yunchuanli003/stm32-3s-battery-monitor/THIRD-PARTY-NOTICES.md

# 第三方组件与商标声明

本仓库包含以下第三方组件，版权归各自所有者，遵循各自许可证。本仓库**未修改**这些文件，仅按原样随工程分发。

---

## 1. STM32F1 HAL Driver

| 项 | 内容 |
|---|---|
| 路径 | `02_固件代码/STM32F103C8T6/LYC1/Drivers/STM32F1xx_HAL_Driver/` |
| 版权 | Copyright (c) STMicroelectronics |
| 许可证 | BSD-3-Clause |
| 许可证全文 | 见同目录 `LICENSE.txt` |
| 许可来源 | <https://opensource.org/licenses/BSD-3-Clause> |

## 2. ARM CMSIS Core

| 项 | 内容 |
|---|---|
| 路径 | `02_固件代码/STM32F103C8T6/LYC1/Drivers/CMSIS/` |
| 版权 | Copyright (c) Arm Limited |
| 许可证 | **Apache License 2.0** |
| 许可证全文 | 见同目录 `LICENSE.txt` |
| 许可来源 | <https://www.apache.org/licenses/LICENSE-2.0> |

## 3. STM32F1 Device 支持包

| 项 | 内容 |
|---|---|
| 路径 | `02_固件代码/STM32F103C8T6/LYC1/Drivers/CMSIS/Device/ST/STM32F1xx/` |
| 版权 | Copyright (c) STMicroelectronics |
| 许可证 | **Apache License 2.0** |
| 许可证全文 | 见同目录 `LICENSE.txt` |
| 许可来源 | <https://www.apache.org/licenses/LICENSE-2.0> |

## 4. 启动文件

| 项 | 内容 |
|---|---|
| 路径 | `02_固件代码/STM32F103C8T6/LYC1/MDK-ARM/startup_stm32f103xb.s` |
| 版权 | Copyright (c) 2017-2021 STMicroelectronics |
| 许可证 | BSD-3-Clause |

---

## 说明

`Drivers/` 与 `MDK-ARM/startup_stm32f103xb.s` 由 STM32CubeMX 依 STM32CubeF1 软件包生成，许可证文件随组件一同保留，未做删改。各组件的版权头均保留在源文件顶部。

各许可证对再分发的要求（保留版权声明、随附许可证副本）均已满足。若你需要基于本项目二次分发，请一并保留 `Drivers/` 目录下的三个 `LICENSE.txt`。

---

## 商标声明

- **STM32**、**STM32F103C8T6** 为 STMicroelectronics International N.V. 的商标或注册商标。
- **Arm**、**Cortex**、**CMSIS** 为 Arm Limited 的商标或注册商标。
- **Keil**、**MDK-ARM** 为 Arm Limited 的商标或注册商标。
- **野火**、**野火小智** 为深圳市野火电子科技有限公司的商标。
- **江科大** 指 B 站 UP 主「江协科技」的 STM32 教学套件，与本项目无隶属关系。
- **Mornsun**、**金升阳** 为广州金升阳科技有限公司的商标。
- **Littelfuse** 为 Littelfuse, Inc. 的商标。
- **嘉立创**、**立创EDA**、**立创商城** 为深圳嘉立创科技集团股份有限公司的商标。

上述名称仅用于说明本项目所用元件、工具与参考对象，**不表示任何官方认证、合作、赞助或背书关系**。本项目为个人学习项目，与上述公司无任何隶属关系。

---

**最后更新**：2026-10-25
