yunchuanli003/stm32-3s-battery-monitor/03_硬件设计/采购记录_20261024.md

# 采购记录（2026-10-24 实际下单）

> 依据：`20261023_采购清单_v2.0.md`（22 料号 / 39 元件）+ 立创购物车实际导出（21 项）
> 用途：焊接时按位号找料，不用翻聊天记录；同时记录哪些料进了备件库
> 状态：立创已下单、淘宝已选定、PCB 已付款

---

## 〇、实际支出

| 单 | 平台 | 内容 | 金额 | 状态 |
|---|---|---|---|---|
| 第 1 单 | 立创商城 | 21 项，611 个元件 | 商品 ¥141.04 → **实付 ¥121.04** | 已下单 |
| 第 2 单 | 淘宝 | NTC 探头 + 尼龙柱 + 螺丝 | 约 ¥20 | 已选定 |
| 第 3 单 | 嘉立创 | 100×80 空板 5 片 | **¥33** | 已付款，预计 10-26/27 到 |
| **合计** | | | **约 ¥174** | |

立创实付拆解：`142.87（原价总额）− 1.83（商品折扣）+ 9（运费）− 20（优惠券）− 9（运费券）= 121.04`

---

## 一、立创商城实购明细（按位号排序）

「板用」= 这块板子实际要焊几个；「余」= 进备件库的数量。

| # | 位号 | 器件 | 规格 | 封装 | 板用 | 买入 | 余 | 料号 | 单价 |
|---|---|---|---|---|---|---|---|---|---|
| 1 | **U1 / U2** | 核心板座 | 2.54 mm 1×20P **排母** | 插件 | 2 | 5 | 3 | `C53207428` | ¥1.2294 |
| 2 | **U3** | LDO（WiFi 专用） | AMS1117-3.3，3.3V / 1A | SOT-223 | 1 | 5 | 4 | `C6186` | ¥1.2509 |
| 3 | **M1** | TB6612 模块座 | 2.54 mm 2×8P **双排母** | 插件 | 1 | 9 | 8 | `C54973830` | ¥1.5674 |
| 4 | **M2** | 5V 降压模块 | K7805-1000R3，8–36V 入 / 5V 1A 出 | SIP 11.5×9 | 1 | 2 | 1 | `C111280` | ¥15.49 |
| 5 | **F1** | 自恢复保险丝 | 1.5 A / 24 V | 1812 | 1 | 5 | 4 | `C78695` | ¥1.2075 |
| 6 | **D1** | 肖特基（防反接） | SS34，40V / 3A | SMA(DO-214AC) | 1 | 20 | 19 | `C2837271` | ¥0.1543 |
| 7 | **D2** | 双向 TVS | SMBJ15CA，Vrwm 15V | SMB(DO-214AA) | 1 | 5 | 4 | `C78809` | ¥0.9932 |
| 8 | **C1 / C2** | 电解电容 | 100 µF / 25 V | 插件 D6.3×L11 | 2 | 50 | 48 | `C49304911` | ¥0.1189 |
| 9 | **C3** | 陶瓷电容 | 22 µF / 25 V | 0805 | 1 | 20 | 19 | `C45783` | ¥1.1682 |
| 10 | **C4~C11、C13~C15** | 陶瓷电容 | 100 nF / 50 V X7R | 0603 | 11 | 50 | 39 | `C14663` | ¥0.0511 |
| 11 | **C12** | 陶瓷电容 | 10 µF / 25 V | 0805 | 1 | 20 | 19 | `C15850` | ¥0.2595 |
| 12 | **R1** | 电阻（分压上臂） | 51 kΩ ±1% | 0805 | 1 | 100 | 99 | `C17737` | ¥0.0407 |
| 13 | **R2 / R3 / R4** | 电阻 | 10 kΩ ±1% | 0805 | 3 | 100 | 97 | `C17414` | ¥0.0202 |
| 14 | **R5 / R6** | 电阻（LED / 蜂鸣器基极） | 1 kΩ | 0603 | 2 | 100 | 98 | `C21190` | ¥0.0101 |
| 15 | **Q1** | NPN 三极管 | S8050，Ic 500mA | SOT-23 | 1 | 50 | 49 | `C364312` | ¥0.0784 |
| 16 | **BUZ1** | 有源蜂鸣器 | Φ12×9.8，5V，2.4kHz，85dB | 插件 D=12 | 1 | 5 | 4 | `C96093` | ¥1.1812 |
| 17 | **SW1** | 轻触按键 | 6×6×5，四脚 | 插件-4P | 1 | 20 | 19 | `C18078025` | ¥0.1191 |
| 18 | **J1 / J2 / J7** | 接线端子 | KF301-2P，5.08 mm | 插件 P=5.08 | 3 | 5 | 2 | `C8465` | ¥0.7642 |
| 19 | **J3** | OLED 接口 | 2.54 mm 1×4P **排母** | 插件 | 1 | 10 | 9 | `C541851` | ¥0.4019 |
| 20 | **J5** | 串口 | 2.54 mm 1×3P 排针 | 插件 | 1 | 20 | 19 | `C2932698` | ¥0.1347 |
| 21 | **J6** | WiFi 接口 | 2.54 mm 1×6P 排针 | 插件 | 1 | 10 | 9 | `C37208` | ¥0.2547 |
| — | **LED1** | 发光二极管 | Φ3 mm 红发红 | 插件 | 1 | **未买** | — | 见下 §1.2 | — |

**校验**：板用合计 = **38**（原 BOM 39 − LED1）。买入合计 **611 个**。

---

## 1.1 料号替换对照（原编号已失效，全部换成现货）

首批 8 个料号在立创搜不到（无货 / 下架），已按**型号**重新查证并换成下列替代件，参数已逐项核对：

| 用途 | 原编号（失效） | 实买编号 | 品牌 / 差异 |
|---|---|---|---|
| 1×20P 排母 | `C50984` 无货 | **`C53207428`** | BXCONN PM-2.54-1×20-8.5-ZZ，8.5mm 高 |
| AMS1117-3.3 | `C5346136` 找不到 | **`C6186`** | AMS 原厂，SOT-223 |
| 2×8P 双排母 | `C42420228` 找不到 | **`C54973830`** | LAILAN，**直插**（首次误买 SMD 立贴，已纠正） |
| SS34 | `C9900023345` 找不到 | **`C2837271`** | JSMSEMI，SMA 40V/3A |
| SMBJ15CA | `C330064` 无货 | **`C78809`** | Littelfuse，SMB 双向 |
| S8050 | `C2931719` 无货 | **`C364312`** | MDD，SOT-23 NPN |
| KF301-2P | `C9900016950` 找不到 | **`C8465`** | WJ500V-5.08-2P |
| 1×4P 排母 | `C5138830` 无货 | **`C541851`** | XFCN，插件 |
| **蜂鸣器** | `C17701079` **需订货** | **`C96093`** | 华能 TMB12A05，Φ12×9.8，5V **有源** 2.4kHz |
| **LED1** | `C9900011189` | **未买** | 套件内 LED 灯珠可用（Φ3/Φ5 均可焊），省这笔 |

### 1.2 LED1 特殊情况

没在立创买，用套件里的裸灯珠。两套教学包配的都是面包板实验件，**大概率是 Φ5**（Φ5 引脚粗，插面包板接触更稳）。拆包后拿尺子量一下灯体直径即可确认。

**Φ3 和 Φ5 都能焊，不存在「装不进去」**（此前记录有误，2026-10-24 更正）：

| 项 | Φ3 LED | Φ5 LED | 板上 `LED-3MM` |
|---|---|---|---|
| 引脚直径 | ~0.45 mm | ~0.6 mm | 孔径 **0.9 mm**，都过得去 |
| 引脚间距 | 2.54 mm | 2.54 mm | 焊盘间距 **2.54 mm**，完全一致 |
| 本体直径 | 3 mm | 5 mm | 丝印轮廓 3 mm，Φ5 会盖住，不影响电气 |

**Φ5 的焊接手法**：Φ5 灯体底部有 Φ5.9 的凸缘，插到底会把两个焊盘完全压住、烙铁进不去。所以插进去先留 2 mm 悬空焊接，焊完两个脚再推到底。

顺序不变：**贴片电阻电容先焊完，LED 最后焊**（先低后高）。

量出来是 5 mm 也不用补单——丝印被盖住不影响任何功能。要好看再单买 `C9900011189`（¥0.01/个，但要凑起送量或运费）。

### 1.3 蜂鸣器极性（装的时候最容易反）

- 板上封装：`BUZ-TH_BD12.0-P7.60-D0.6`（Φ12.0 / 脚距 7.6mm / 脚径 0.6）
- 丝印「**+**」在**板子左侧**（x=10.20），对应 1 脚 `+5V`
- **正极脚（长脚）插左边**，2 脚接 Q1 集电极

---

## 二、淘宝单（已选定）

| 物品 | 规格 | 实选 | 数量 | 金额 |
|---|---|---|---|---|
| NTC 温度探头 | **10 kΩ B=3950**，两线，线长 500mm，**线尾 3mm 上锡** | 博创电器，**水滴头** | 2 | ¥2~5 |
| 尼龙柱 | **双通**内螺纹、M3×10、平头六角 | 佰瑞特，M3×10 白色 | 100 | ¥6.16 |
| 螺丝 | M3×6，尼龙，十字盘头 | 固方基，M3×6 黑色 | 40 | ¥2.5 |

### 2.1 三个坑，已逐一避开

1. **NTC 必须是裸两线探头**，不要「热敏电阻传感器模块」（那是 LM393 比较器板，4 脚，AO 低阻输出会和板上 R3 上拉对打）
2. **NTC 的 B 值必须 3950**。买 3435 的话 25℃ 附近还准，往后每 10℃ 偏 1~2℃，整个量程都歪——固件里写死 `NTC_B = 3950.0f`
3. **尼龙柱必须「双通」**（两端都是内螺纹）。第一次选成「单通 M3×10+6」（下端是外螺纹），**裸板没有底板就固定不了**。双通柱底部平整，才能当脚立在桌面上

### 2.2 装配尺寸验算（已核对）

| 项 | 数值 | 结论 |
|---|---|---|
| 六角对边 5.5mm → 外接圆半径 | 3.17mm | 孔心距板边 5mm，余 **1.83mm**，不超板边 |
| 柱长 10mm vs 板底焊点高度 | 10 vs 2~3mm | 余 **7mm**，够 |
| M3×6 螺杆穿板后余量 | 6 − 1.6 = 4.4mm | 咬合 4.4mm，够力（标准 ≥0.75mm） |
| 螺丝头 φ5.6 vs 孔心距板边 | 5 − 2.8 = 2.2mm | 不超板边，不压走线 |

---

## 三、PCB（已付款）

| 项 | 值 |
|---|---|
| 板框 | 100 × 80 mm，2 层，1.6 mm，1 oz |
| 表面处理 | 有铅喷锡（**不是** OSP —— OSP 不耐反复加热，手工返修会掉）。样机不进入流通领域，商品化时须改无铅以满足 RoHS |
| 确认生产稿 | **需要**（自绘板唯一能在开产前拦 Gerber 错误的环节） |
| 数量 / 费用 | 5 片 / **¥33**（板材 20 + 确认生产稿 3 + 品质赔付 10） |
| 安装孔 | 四角 M3 **非金属化**，孔心 (5,5)/(95,5)/(5,75)/(95,75) |
| 预计到货 | 10-25 晚发货，10-26/27 到 |

⚠️ **生产稿通知到了先截图核对，不要自己点确认。** 重点看：板框 100×80、过孔盖油、丝印有没有压焊盘。

---

## 四、板子到货后第一件事（验收四步）

1. **量尺寸**：游标卡尺量四角孔径（应 3.2mm）、板框（应 100×80）、核心板两排针间距（应 22.86mm）
2. **对极性丝印**（四类，装反都要返工）：
   - C1 / C2 电解：**「+」在左侧**
   - D1 SS34：**阴极带在右侧**
   - LED1：**「+」在右侧**
   - BUZ1 蜂鸣器：**「+」在左侧**
3. **看 J3 插装方向**：1 脚位置与丝印方焊盘是否一致
4. **3D 预览目视**：拿实物对照 `pcb_polarity_zoom.png`

---

## 五、焊接耗材（如缺则补）

| 物品 | 用途 | 是否必备 |
|---|---|---|
| 焊锡丝 0.6–0.8mm **含铅** | 手焊 0603/0805，熔点低好操作 | 必备 |
| 助焊剂（松香或免洗膏） | 焊 0603 时让锡自己爬到位 | 必备 |
| 吸锡带 | 连锡了补救 | 必备 |
| 尖头镊子 | 夹 0603 元件 | 必备 |
| 无水酒精 + 棉签 | 洗助焊剂残留 | 建议 |
| 放大镜 / 手机微距 | 检查虚焊 | 建议 |

---

## 六、到货后先别焊：分装

0603 的电阻电容肉眼分不出 1k 和 10k。**到货第一件事是按位号分装**，20 分钟换焊接时省 2 小时：

| 袋子 | 装什么 | 数量 |
|---|---|---|
| R1 | 51 kΩ 0805 | 取 2 个 |
| R2/R3/R4 | 10 kΩ 0805 | 取 6 个 |
| R5/R6 | 1 kΩ 0603 | 取 4 个 |
| C1/C2 | 100 µF 电解 | 取 3 个 |
| C3 | 22 µF 0805 | 取 2 个 |
| C12 | 10 µF 0805 | 取 2 个 |
| C4~C15 | 100 nF 0603 | 取 20 个 |
| 其余 | 排母、排针、端子、三极管、二极管、按键、蜂鸣器 | 按表取 |

---

**经验教训**

1. **立创购物车的数量受「最小起送量」约束**，不是所有料都能拆零买。22 µF 20 个 ¥23.36、100 µF 50 个、4 个电阻各 100 个——全是整包量。下次列 BOM 直接按「整包量」预估总价，别按实际用量报数，否则预算对不上（这次预估 ¥70，实际 ¥141）。
2. **C 编号会随品牌批次失效**，长期稳定的是「型号 + 关键参数」。查料按型号搜，别死磕编号。
3. **插件 vs 贴片看封装栏**：「插件 / 直插 / DIP」要打孔，「SMD / 贴片 / 立贴」贴表面。板上预留的是直插孔，就不能买 SMD。
4. **排母要分清行距**：2.54 排母有「行距 2.54」和「行距 2.0」两种，TB6612 模块是标准 2.54 双排。
