yunchuanli003/stm32-3s-battery-monitor/01_文档资料/02_问题跟踪/20260604_串口打印延迟问题修复计划_v1.0.md

# 串口打印延迟问题修复计划

## 问题分析

现象：
1. KEY2短按停止系统后，串口不打印"系统已经停止"信息
2. 按下RESET复位后，"系统已经停止"和"系统已经开启"的信息一起打印出来

## 根本原因

**串口发送缓冲区问题**：虽然 `fputc` 使用了 `HAL_UART_Transmit` 阻塞发送，但在系统状态切换时，可能存在以下问题：

1. **按键释放时触发**：短按逻辑在按键释放时才触发停止，此时可能系统状态有变化
2. **缺少发送完成确认**：printf 后没有等待串口真正发送完成
3. **逻辑时序问题**：可能某些操作影响了串口发送

## 修复方案

### 方案：先打印信息，等待发送完成，再改变系统状态

1. 调整按键逻辑，确保 printf 后添加短暂延时
2. 使用 `HAL_UART_GetState()` 确认串口发送完成
3. 优化蜂鸣器反馈的时机

## 具体修改步骤

### 步骤1：优化按键扫描函数
**文件：** `02_固件代码/STM32F103C8T6/LYC1/Core/Src/main.c`
- 短按停止：printf 后增加延时，确保串口发送完成
- 长按开启：同样确保打印完成

### 步骤2：添加发送完成等待
**文件：** `02_固件代码/STM32F103C8T6/LYC1/Core/Src/main.c`
- 使用 `while(HAL_UART_GetState(&huart1) != HAL_UART_STATE_READY)` 等待发送完成
- 或添加足够的延时（约20-50ms）

## 代码修改清单

| 文件 | 修改内容 |
|---|---|
| `Core/Src/main.c` | 优化按键扫描中的串口打印逻辑，确保信息发送完成 |

## 验证方法

1. 烧录修改后的代码
2. 短按KEY2，串口应立即显示"系统已经停止"
3. 长按KEY2，串口应立即显示"系统已经开启"
4. 不需要按复位就能看到打印信息
