yunchuanli003/stm32-3s-battery-monitor/01_文档资料/02_问题跟踪/20260604_按键无响应问题修复计划_v1.0.md

# 按键无响应问题修复计划

## 问题分析

现象：
- RESET按键正常（系统复位）
- KEY1和KEY2两个按键都没有效果

## 根本原因排查

### 可能原因1：PC13引脚特殊性
STM32F103C8T6的PC13引脚有以下特性：
- PC13/PC14/PC15通常用于RTC（实时时钟）功能
- 作为GPIO输出时，驱动能力有限
- 作为输入时可能需要特殊处理

### 可能原因2：按键扫描频率问题
- 系统运行时主循环延时900ms
- 按键扫描只在循环开始时执行一次
- 可能错过按键按下的时机

### 可能原因3：硬件连接问题
- 野火核心板的按键实际接法可能与例程不一致
- 需要实际测试确认引脚电平

## 修复方案

### 方案一：优化按键扫描（推荐）
1. 增加按键扫描频率，每50ms扫描一次
2. 将按键扫描与主循环延时分离
3. 使用独立的时基或缩短延时

### 方案二：添加按键测试代码
1. 在按键按下时添加蜂鸣器或LED反馈
2. 方便调试确认按键是否被识别

### 方案三：确认PC13引脚配置
1. 检查PC13是否有其他功能占用
2. 确认上下拉配置是否正确

## 具体修改步骤

### 步骤1：优化主循环结构
**文件：** `02_固件代码/STM32F103C8T6/LYC1/Core/Src/main.c`
- 缩短主循环延时到100ms
- 使用计数器控制ADC采样频率（1秒一次）
- 确保按键每100ms扫描一次

### 步骤2：添加按键调试反馈
**文件：** `02_固件代码/STM32F103C8T6/LYC1/Core/Src/main.c`
- 按键按下时，蜂鸣器"滴"一声作为反馈
- 方便确认按键是否被识别

### 步骤3：修正PC13引脚配置（如果需要）
**文件：** `02_固件代码/STM32F103C8T6/LYC1/Core/Src/gpio.c`
- 确认PC13的上下拉配置是否正确
- 如果有问题，改为上拉或浮空

## 代码修改清单

| 文件 | 修改内容 |
|---|---|
| `Core/Src/main.c` | 优化主循环，增加按键扫描频率，添加按键反馈 |
| `Core/Src/gpio.c` | 确认并修正按键引脚配置 |

## 验证方法

1. 烧录修改后的代码
2. 按下KEY1，蜂鸣器应滴一声，串口显示"系统已经开启"
3. 按下KEY2，蜂鸣器应滴一声，串口显示"系统已经停止"
4. 如果按键有响应但功能不对，再调整具体逻辑
