yunchuanli003/stm32-3s-battery-monitor/03_硬件设计/PCB设计/20261021_PCB打样设计输入_v1.0.md

# PCB 打样设计输入（第一版）

> 目标：把现有面包板方案转成一块可打样的 2 层板，功能与 v2.0 固件保持一致
> 工具：立创EDA（专业版）
> 状态：原理图已于 2026-10-22 完成 4 页；PCB 已于 2026-10-23 完成布局 + 布线 + 铺铜 + DRC，Gerber 已导出。第三、四节已按实际网表校准

---

## 〇、三个设计前提

| 前提 | 选择 | 理由 |
|---|---|---|
| MCU 形态 | **沿用现成核心板**，用两个 1×20P 排母（合计 40 脚）插装 | 核心板自带晶振、复位、USB、3.3V LDO，省掉最容易翻车的部分；第一次打样不值得冒这个险 |
| 电机驱动 | **TB6612 模块**，2×8 排母插装 | FNG 芯片是 SSOP-24，手工焊接成功率低；模块几块钱，坏了直接换 |
| 降压 | **K7805-1000R3 开关稳压模块**（金升阳 MORNSUN，C111280） | 8–36 V 入、5 V/1 A 出、效率 93%、SIP-3 直插、引脚与 LM78xx 兼容。**选它而不选淘宝 MP1584 迷你模块的原因**：有完整规格书、焊盘落在 2.54 网格上。淘宝 22×17 迷你模块的焊盘「端到端不在 0.1″ 网格」，物理上插不进任何排母，也插不进面包板 |

> 这套思路叫"模块化降风险"：把不可控的环节（焊接、开关电源布局）交给成熟模块，自己只画可控的部分（接口、采样、保护、指示）。
> 这套「模块化降风险」的取舍理由是可复述的：能讲清为什么第一版不集成，比画得花哨更显工程判断。

---

## 一、电源架构（最关键的一节）

```
3S 电池 9.0–12.6 V
   │
   ├─ 保险丝 1.5 A → 防反接 SS34 → ├─ Buck(K7805) → 5 V ─┬─ 核心板 5V 引脚（板载 LDO 再降 3.3 V）
   │                              │                      ├─ 蜂鸣器（有源 5 V）
   │                              │                      └─ U3 AMS1117-3.3 → +3V3_WIFI（WiFi 专用，见 11.2）
   │                              └─ TB6612 VM（12.6 V 直供）→ 130 电机
   └─ GND
```

**为什么不是 12.6 V 直接降到 3.3 V**

AMS1117 类是线性稳压，压差全变成热。12.6 V → 3.3 V、负载 70 mA，功耗 ≈ 0.65 W，SOT-223 封装结温会逼近 125 ℃ 触发过温保护，表现为输出电压跌落、MCU 反复复位。这类故障极难从软件侧定位。

**为什么走 5 V 再进核心板**

核心板板载 LDO 吃 5 V 只需降 1.7 V，功耗约 0.12 W，安全。这样整块板只做一级 Buck，架构最简单。

**必须加的元件**

| 位置 | 元件 | 作用 |
|---|---|---|
| 电池入口 | 自恢复保险丝 1.5 A（如 MF-MSMF150） | 短路保护 |
| 电池入口 | SS34 肖特基（SMA 封装） | 防反接；正常压降 0.5 V，12.6 → 12.1 V，可接受 |
| Buck 输入 | 100 µF/25 V 电解 + 0.1 µF 陶瓷 | 抑制电池线束电感引起的输入纹波 |
| Buck 输出 5 V | 22 µF + 0.1 µF | 输出储能与高频去耦 |
| TB6612 VM | 100 µF/25 V 电解 + 0.1 µF，**紧贴模块 VM 与 GND 引脚** | 电机换向瞬间的电流尖峰靠它吸收 |
| 电机端子 | 0.1 µF 跨接电机两端 + 双向 TVS（SMBJ15CA） | 换向反电动势泄放 |

---

## 二、模拟采样电路

### 2.1 电压采样

| 项 | 取值 |
|---|---|
| 上臂 R1 | 51 kΩ，1%，0805 |
| 下臂 R2 | 10 kΩ，1%，0805 |
| 分压比 | (51+10)/10 = **6.10** |
| 12.6 V 时分压点电压 | 2.07 V（ADC 满量程 3.3 V，余量充足） |
| 源阻抗 | 51k ∥ 10k ≈ **8.4 kΩ**（STM32F1 在 239.5 周期采样下允许约 50 kΩ，安全） |
| 滤波 | 分压点对地 **100 nF**（X7R，0603），走线尽量短，紧贴 PA4 |
| 分辨率 | 3.3 V / 4095 ≈ 0.806 mV，折算到电池端约 **4.9 mV** |

> 换 1% 电阻后，固件里的 `divider_k = 6.21f` 需要按实测重新标定一次（原值来自旧电阻的实际误差）。
> 标定方法沿用你原来的：万用表实测电池电压 → `新系数 = 旧系数 × 实测值 / 显示值`。

### 2.2 温度采样

| 项 | 取值 |
|---|---|
| NTC | 10 kΩ，B=3950，1%，**外接式防水探头，不焊在板上** |
| 接入方式 | 2P 螺钉端子 **J7**（KF301-2P，与 J1/J2 同款），探头引线拧入端子，探头主体贴电池壳体 |
| 上拉 | 10 kΩ，1%，接 3.3 V |
| 接法 | **NTC 在下臂**（NTC 到 GND，上拉电阻到 3.3 V） |
| 25 ℃ 时分压点 | 1.65 V |

**NTC 走 J7 端子外接，而不是直插焊在板上。** 三个理由：① NTC 必须贴到电池壳体上才测得到电芯温度，焊死在板子上只能测环境温度；② 裸 NTC 珠子没有机械强度，四根引线被反复弯折会断在根部；③ 端子让探头可更换——B 值不对、量程不合适直接换一根，不用动板子。

> 注意：江科大套件里那款「热敏电阻传感器模块（4 脚：VCC/GND/DO/AO）」**不能用**。它是 LM393 比较器模块，AO 是低阻运放输出，接到本板 J7 上会与 R3 上拉直接对打，而且它自带一路分压，等于两次分压、量程全乱。要买的是**裸 NTC 探头**（10 kΩ B3950，两根线，防水封装）。

**接法必须保持 NTC 在下臂**，这样温度升高 → NTC 阻值下降 → 分压点电压下降，与现有固件 `temperature = 25.0f + (1.65f - temp_volt) * 15.0f` 的方向一致，改板不用改代码。

**但这条公式建议重写。** 10 k/B3950 在 25 ℃ 附近灵敏度约 4 %/℃，换算成电压约 25~27 ℃/V，而当前用 15 ℃/V，斜率只有实际的一半左右。粗算下来：

| 实际温度 | 分压点电压 | 当前公式读数 | 偏差 |
|---|---|---|---|
| 25 ℃ | 1.65 V | 25.0 ℃ | 0 |
| 28 ℃ | 1.57 V | 26.2 ℃ | −1.8 ℃ |
| 32 ℃ | 1.48 V | 27.5 ℃ | −4.5 ℃ |
| 35 ℃ | 1.42 V | 28.4 ℃ | −6.6 ℃ |

温度越高偏差越大，而风扇的两个阈值（28 ℃、32 ℃）正落在这段区间。**打样顺手把温控改准，是这个项目最划算的一次改进**——硬件不用动，只换固件里的换算方式（查表或 Steinhart-Hart），误差能从数度降到 0.5 ℃ 内。

### 2.3 按键

10 kΩ 上拉到 3.3 V，并联 100 nF 做硬件消抖，再进 PC13。软件里的 10 次计数消抖可以保留，也可以减到 3 次。

---

## 三、器件清单

> 已按位号排序，与立创 EDA 网表逐项对应（共 39 个元件，不含安装孔）。LCSC 编号可直接导入商城 BOM。

| 位号 | 器件 | 规格 | 封装 | 数量 | LCSC |
|---|---|---|---|---|---|
| U1 / U2 | 核心板座 | 2.54 mm **1×20P 排母**（两块拼成 40 脚） | 直插 | 2 | C50984 |
| U3 | 独立 LDO（WiFi 专用） | AMS1117-3.3 | SOT-223 | 1 | C5346136 |
| M1 | TB6612 模块座 | 2.54 mm 2×8P 双排母，DS1023-02-2x8SF11 | 直插 | 1 | C42420228 |
| M2 | 5 V 降压模块（开关型） | K7805-1000R3，8–36 V 入 / 5 V 1 A 出，效率 93%，立式高 17.5 mm | SIP-3 直插 | 1 | C111280 |
| F1 | 自恢复保险丝 | 1.5 A / **24 V** | 1812 | 1 | C78695 |
| D1 | 肖特基（防反接） | SS34 | SMA | 1 | C9900023345 |
| D2 | 双向 TVS | SMBJ15CA | SMB | 1 | C330064 |
| C1 / C2 | 电解电容 | 100 µF / 25 V | 直插 φ6.3 | 2 | C49304911 |
| C3 | 陶瓷电容 | 22 µF / **25 V** | 0805 | 1 | C45783 |
| C4~C10 | 陶瓷电容（`+5V` 去耦） | 100 nF / 50 V X7R | 0603 | 7 | C14663 |
| C11 | 陶瓷电容（PA4 ADC 滤波） | 100 nF / 50 V | 0603 | 1 | C14663 |
| C12 | 陶瓷电容 | 10 µF / **25 V** | 0805 | 1 | C15850 |
| C13 | 陶瓷电容（`+3V3_WIFI` 去耦） | 100 nF / 50 V | 0603 | 1 | C14663 |
| C14 | 陶瓷电容（PA5 ADC 滤波） | 100 nF / 50 V | 0603 | 1 | C14663 |
| C15 | 陶瓷电容（PC13 按键消抖） | 100 nF / 50 V | 0603 | 1 | C14663 |
| R1 | 电阻（分压上臂） | 51 kΩ ±1% | 0805 | 1 | C17737 |
| R2 | 电阻（分压下臂） | 10 kΩ ±1% | 0805 | 1 | C17414 |
| R3 | 电阻（NTC 上拉） | 10 kΩ ±1% | 0805 | 1 | C17414 |
| R4 | 电阻（按键上拉） | 10 kΩ ±1% | 0805 | 1 | C17414 |
| R5 | 电阻（LED 限流） | 1 kΩ | 0603 | 1 | C21190 |
| R6 | 电阻（蜂鸣器基极） | 1 kΩ | 0603 | 1 | C21190 |
| Q1 | NPN 三极管 | S8050 | SOT-23 | 1 | C2931719 |
| BUZ1 | 有源蜂鸣器（内含驱动线路） | HYE1206-05ST，5 V，2.6 kHz，Φ12，脚距 7.6 | 直插 | 1 | C17701079 |
| LED1 | 发光二极管 | Φ3 mm 红 | 直插 | 1 | C9900011189 |
| SW1 | 轻触按键 | 6×6×5，四脚 | 直插 | 1 | C18078025 |
| J1 | 电池输入端子 | KF301-2P | 直插 | 1 | C9900016950 |
| J2 | 电机输出端子 | KF301-2P | 直插 | 1 | C9900016950 |
| J3 | OLED 接口 | 2.54 mm 1×4P **排母**（模块公针直插） | 直插 | 1 | C5138830 |
| J5 | 串口 | 2.54 mm 1×3P 排针 | 直插 | 1 | C2932698 |
| J6 | WiFi 模块 | 2.54 mm 1×6P 排针 | 直插 | 1 | C37208 |
| J7 | NTC 温度探头端子 | KF301-2P | 直插 | 1 | C9900016950 |
| H1~H4 | 安装孔 | M3，内径 3.2 mm，非金属化 | — | 4 | — |

**四处需要留意**：

1. **M1 已锁定 C42420228**（DS1023-02-2x8SF11）。原先用的通用件「2.54 2」对应料号 C9900000696 是库里的残件——元件属性看着齐全，但网表只导出 `DESIGNATOR / FOOTPRINT / PARTTYPE` 三行，`Supplier Part` 永远为空，怎么改属性都不生效。已换成完整的 DS1023 重画，16 个引脚网络逐个复核通过。
2. **U1/U2 是两个独立的 1×20P 排母**，不是一体式 2×20P。野火核心板是两条 20 脚单排针，买 2×20 一体座插不进去。
3. **NTC 不再作为板上元件（RN1 已删除）**，改为 J7 端子 + 外购防水探头。BOM 里因此没有 NTC，探头需在淘宝单独买（10 kΩ B3950 防水型，2 根为一份，留一根备用）。
4. **板上不再有 SWD 调试口（J4 已删除，2026-10-23）**。原 J4 是 1×4P 排针，接 `+3V3 / SWDIO / SWCLK / GND`，但 `SWDIO`、`SWCLK` 在网表里**各自只有 J4 自己的一个脚**——野火核心板的 40 针排母根本没有引出 PA13/PA14，这块板上插 DAP 进去也识别不到芯片。调试改走**核心板自带的调试排针**（板上有丝印，直连 PA13/PA14），烧录走核心板 Type-C。省下 4 个焊盘和一段容易在答辩时被追问的丝印。

---

## 四、网络连接表（画原理图的直接依据）

> 本表已于 **2026-10-22** 按立创 EDA 实际网表（Protel2）校准，引脚号以 `位号-脚号` 写死。

| 网络名 | 连接对象 |
|---|---|
| `VBAT` | J1-1、F1-1 |
| `VBAT_FUSE` | F1-2、D1-2（**阳极**）。保险丝之后、防反接之前，只有这一段 |
| `VBAT_F` | D1-1（**阴极**）、M2-1（K7805 **Vin**）、C1-1、C2-1、M1-1（TB6612 VM）、R1-1（分压上臂）。**全板主母线，都在防反接之后** |
| `+5V` | M2-3（K7805 **Vout**）、C3-1、U3-3（IN）、C4~C10、U1-19（5V 引脚）、BUZ1-1 |
| `+3V3` | U1-15 / U1-17、U2-1 / U2-20、M1-2（TB6612 VCC）、J3-2、R3-1、R4-1 |
| `GND` | J1-2、M2-2、C1-2、C2-2、C3-2、C4~C11 的 -2 脚、C12-2、C13-2、C14-2、C15-1、U3-1、R2-2、**J7-2**、M1-3 / M1-8 / M1-13~16、Q1-2、LED1-1、SW1-1 / SW1-2、U1-18 / U1-20、U2-2 / U2-19、J3-1、J5-1、J6-2、H1~H4 |
| `PA4` | R1-2、R2-1、C11-1、U1-10 |
| `PA5` | R3-2、**J7-1**、C14-1、U1-9 |
| `PB12` / `PB13` | M1-11（AIN1）/ M1-10（AIN2）（原 PA2/PA3，见引脚冲突核查） |
| `PA6` | M1-9（PWMA） |
| `PB14` | M1-12（STBY）（原 PA8） |
| `AO1` / `AO2` | M1-4 / M1-5 → J2-1 / J2-2；D2 跨接在这两端（双向 TVS） |
| `PB0` | U1-6、R6-1（→ Q1-B），Q1-C → BUZ1-2 |
| `PB1` | U1-5、R5-1 → LED1-2（阳极） |
| `PB6` / `PB7` | U2-15 / U2-16 → J3-3（SCL）/ J3-4（SDA） |
| `PA9` / `PA10` | U2-5 / U2-6 → J5-2（TX）/ J5-3（RX） |
| `PC13` | U1-16、R4-2、SW1-3 / SW1-4、C15-2 |
| `USART3_TX` | U1-4（PB10）→ J6-3（接模块 RX） |
| `USART3_RX` | U1-3（PB11）→ J6-4（接模块 TX） |
| `+3V3_WIFI` | U3-OUT、C12、C13、J6-1 |
| `WIFI_EN` | J6-5 → 模块使能。**板上不设上拉**：NodeMCU V3 底板自带 10 kΩ 上拉到 3.3 V + RST 按键，两处 10 kΩ 并联只会变成 5 kΩ，无收益。该网络仅 J6-5 一个引脚，DRC 的单引脚告警**属有意为之** |
| `WIFI_IO0` | J6-6 → 烧录模式选择。**板上不设上拉**：NodeMCU 底板自带 10 kΩ 上拉 + FLASH 按键，拉低进下载。该网络仅 J6-6 一个引脚，DRC 的单引脚告警**属有意为之** |

> ### ✅ D1 接法已修正（2026-10-22，方案 A）
>
> 原图纸把 D1 只串在 Buck 这一路：`VBAT_F` 挂在阳极侧，TB6612 VM 与 C1/C2 两颗 100 µF 电解直接承受反接电压，电解会鼓包爆裂。
>
> 现改为 **`F1-2` → D1 阳极，D1 阴极 → `VBAT_F` 主母线，Buck 也从母线取电**。全板（TB6612 VM、电解、分压、Buck）统一受 SS34 保护。
>
> 网表已复核：`VBAT_FUSE` = F1-2 + D1-2(A)；`VBAT_F` = D1-1(K) + M2-1 + C1-1 + C2-1 + M1-1 + R1-1；原 `VBAT_IN` 网络消失。DRC 无新增告警。
>
> 代价：电机端少一个肖特基压降（12.6 → 12.1 V，约 4%），SS34 在 1.5 A 下耗散约 0.75 W，选型需注意散热。

---

## 五、布局约束（先摆位，再拉线）

板子建议 **100 × 80 mm 以内**，四角 M3 安装孔。

| 区域 | 位置 | 放什么 |
|---|---|---|
| 电源区 | 左侧，靠近电池端子 | J1、F1、D1、C1、Buck 模块、C3 |
| 功率区 | 右下，靠近电机端子 | TB6612 模块、C2、J2、D2 |
| 模拟区 | 中部偏上 | R1、R2、R3、**J7**、C11 ×2 |
| 数字区 | 中部 | U1（核心板）、SW1、OLED、LED、蜂鸣器 |
| **扩展预留区** | 右上角，贴板边 | WiFi/BLE 模块排针位（J6）+ 天线净空带 |

四条硬约束：

1. **ADC 滤波电容紧贴 PA4 / PA5 引脚**，中间不串过孔，走线长度控制在 5 mm 内
2. **TB6612 的 100 µF 电解必须紧贴模块 VM 与 GND 引脚**，走线宽度 ≥ 1 mm
3. **电机大电流回路（VM → TB6612 → 电机 → GND）面积越小越好**，不要绕板子一圈
4. **右上角沿板边留 30 × 20 mm 空区**，且该区域正对的天线净空带内**不铺铜、不走线、不放器件**（详见第十一节）
5. **J7 靠板边放**（螺钉端子的进线口朝外），距板边 ≥ 2 mm 且 ≤ 6 mm，探头引线能直接出板不被器件挡住；不要放在核心板正下方，否则探头要先绕过整块板

接地策略：底层整块铺 GND 不切碎；功率地与信号地在电池端子处单点汇合，不要在两处相连形成环路。

---

## 六、布线要点

| 线类 | 宽度 | 说明 |
|---|---|---|
| 电机回路（VM、OUT1/OUT2、GND） | 2.0 mm 或铺铜 | 130 电机堵转峰值可达 1.5 A |
| 12 V 输入 | 1.0 mm | |
| 5 V | 0.8 mm | |
| 普通信号 | 0.25 mm | |
| ADC 走线 | 0.25 mm，两侧包地 | 远离 PWM 与电机走线 |

顺序建议：**电源 → 功率 → 模拟 → 信号**。先画电流最大的，再画最敏感的。

---

## 七、嘉立创打样参数

| 项 | 选择 | 实际落实情况（2026-10-23） |
|---|---|---|
| 层数 | 2 层 | ✅ 顶层信号 + 底层信号，双面 GND 铺铜 |
| 板材 / 厚度 | FR-4，1.6 mm | ✅ 1.6 mm（嘉立创唯一不加价档，0.8~1.6 常规板；2.0 mm 属非标要换压合模具） |
| 铜厚 | 1 oz（35 μm） | ✅ 1 oz（2 oz 蚀刻时间延长、产能下降，基础费加收约 30%） |
| 阻焊 / 丝印 | 绿色 / 白色 | ✅ 绿色（蓝/红/白每款加 50 元，绿色不加） |
| 表面处理 | 喷锡。**本样机按有铅下单**，仅因手工焊接熔点低、返修容易 | ✅ 喷锡（沉金加 100 元，无铅喷锡加 30 元） |
| 最小线宽/间距 | 6/6 mil | ✅ 信号线 **10 mil (0.254 mm)**，最小光圈 8 mil；间距规则未报任何违规 |
| 最小过孔 | 0.3 / 0.6 mm | ✅ **0.3 mm 孔 / 0.61 mm 盘**，焊环 0.155 mm（嘉立创双面板最小焊环 0.13 mm） |
| 尺寸 | ≤ 100 × 100 mm（5 片档位最划算） | ✅ **100 × 80 mm**，Gerber 实测板框 100.000 × 80.001 mm |
| 拼板 | 不需要，单片即可 | ✅ 单片 |
| 安装 | — | ✅ 4 个 M3 孔，孔径 3.2 mm / 外径 3.6 mm，**非金属化（NPTH）**，孔心距板边 5 mm |

> **环保合规说明**：本板为个人验证样机，不进入流通领域，故未按 RoHS 选无铅工艺。若该设计需要商品化或送第三方检测，应改用**无铅喷锡**（嘉立创加价约 ¥30 即可满足工艺要求），并按 **RoHS 2011/65/EU** 与 **GB/T 26572** 核对 BOM 中 22 个料号的有害物质声明，重点核查电解电容、蜂鸣器、LED 的铅 / 镉 / 汞 / 六价铬 / 多溴联苯（PBB）/ 多溴二苯醚（PBDE）含量。

**电源走线加粗**（1 oz 铜、温升 10 ℃ 时 1 mm 宽约 2.3 A，电机堵转约 1 A，留 2 倍以上余量）：

| 网络 | 路径 | 线宽 |
|---|---|---|
| `VBAT` | J1 → F1 | **1.5 mm** |
| `VBAT_FUSE` | F1 → D1 | **1.5 mm** |
| `VBAT_F` | D1 → 主母线（M2 输入侧） | **1.5 mm** |
| `+5V` | M2 → C3、C8 → C7 | **1.0 mm** |
| `+5V` / 信号 | 其余段 | 0.254 mm |
| 电机 `AO1`/`AO2` | M1 → D2 / J2，沿模块底部绕行 | 0.254 mm（电流 <1 A，走线短，线宽够） |

---

## 七之二、实际布线结果（2026-10-23 定版，替代原「布线要点」的估算）

| 项 | 实测值 |
|---|---|
| 元件 | **39 个**（与原理图网表一致） |
| 走线 | **200 段**（顶层 139 / 底层 61），26 个信号网络 100% 布通 |
| 过孔 | **52 个**（4 个信号换层 + 48 个 GND 缝合），全部 0.3 mm 孔 / 0.61 mm 盘 |
| 铺铜 | **2 块**（顶层 / 底层各一块 GND，实心填充，内缩 0.3 mm），已重建铜皮 |
| DRC | **0 违规**（Clearance 0、Connection 0）。关闭文档重开后复测一致 |
| 板框 | 闭合单一 Polyline，图层 11，100 × 80 mm |
| Gerber | `05_交付产物/Gerber/Gerber_下单版_100x80_2L.zip`（11 个文件，81 KB） |

**布线顺序**：自动布线（26 个信号网络）→ 手工加粗电源主干 → 双面 GND 铺铜 → 铺铜管理器「重建所有」→ 补两个模拟区孤岛焊盘 → DRC 归零 → 导出 Gerber。

**两处需要知道的结构性妥协**（不是错误，是布局约束的必然结果）：

1. **核心板排针缝隙只有 0.74 mm**，穿过缝隙的走线无法加粗，保持 0.254 mm。这属于信号线，无载流要求。
2. **M1（TB6612）的 1 脚 VM 与 4/5 脚 AO1/AO2 在同一侧（左侧）**，电机线从左侧引脚出发后沿模块底部绕到右侧的 D2 / J2。模块插在排针上悬空，底部有 8.5 mm 空间，走线不受影响；装配时注意别把线压到模块底下。

**Gerber 文件清单**（下单包已剔除 7 个非制造文件：`TopPasteMask`、`Document`、`DrillDrawing` 与 4 个 `Fabrication_Colorful*` 彩色丝印层，避免嘉立创解析时误判为彩色丝印订单）：

| 文件 | 内容 |
|---|---|
| `Gerber_TopLayer.GTL` | 顶层铜 |
| `Gerber_BottomLayer.GBL` | 底层铜 |
| `Gerber_TopSilkscreenLayer.GTO` / `Gerber_BottomSilkscreenLayer.GBO` | 顶/底丝印 |
| `Gerber_TopSolderMaskLayer.GTS` / `Gerber_BottomSolderMaskLayer.GBS` | 顶/底阻焊 |
| `Gerber_BoardOutlineLayer.GKO` | 板框 100.000 × 80.001 mm |
| `Drill_PTH_Through.DRL` | 金属化孔（元件脚） |
| `Drill_NPTH_Through.DRL` | **非金属化孔：4 个 3.19989 mm**（M3 安装孔） |
| `Drill_PTH_Through_Via.DRL` | 过孔 52 个 |

---

## 八、下单前检查单

- [x] DRC 检查 0 错误，警告逐条确认过（2026-10-23：Clearance 0、Connection 0，关闭重开后复测一致）
- [x] 丝印没有压在焊盘上（2026-10-23 栅格化核算：仅 LED1 焊盘边缘 0.64 mm²，占 0.2%，会被自动裁掉，见 8.1）
- [ ] 电解电容、二极管、LED、蜂鸣器**极性方向**与实物一致（丝印标记位置见 8.2，需拿实物对）
- [ ] NTC 与 10 k 上拉的位置没搞反（搞反会导致温度越高读数越高）
- [x] **J7 两脚没接反**：1 脚 = `PA5`（经 R3 上拉到 3.3 V），2 脚 = `GND`（网表已核）
- [ ] 排母间距与模块实测核对（TB6612 模块有 2.54 和 2.0 两种）
- [x] 安装孔不与其他铜皮短路（4 个 NPTH 非金属化，孔径 3.2 mm）
- [x] Gerber 逐层预览：顶层、底层、丝印、阻焊、钻孔、板框（文件清单见七之二）
- [x] 板框是闭合的单一轮廓（Polyline 闭合，图层 11，100.000 × 80.001 mm）
- [ ] BOM 位号与 PCB 一一对应（**导出坐标文件后逐条核**）
- [ ] 3D 预览看过一遍，确认元件不打架（**只看 4 类高个子**：K7805 立式 17.5 mm 高在 (43.5,11)、电解 C1/C2 约 11 mm 高、BUZ1 蜂鸣器 12×9.5、插上核心板后高出板面约 10 mm。核心板覆盖区 y=26~48.86 内没有放任何元件，其余都是矮件）

### 8.1 丝印与阻焊开窗的重叠检查（2026-10-23 按 Gerber 栅格化核算）

把 Gerber 的丝印层（GTO）与阻焊层（GTS）各栅格化成 0.05 mm 位图求交：

| 层 | 丝印总面积 | 落在阻焊开窗内 | 占比 |
|---|---|---|---|
| 顶层丝印 | 269.68 mm² | **0.64 mm²** | 0.2% |
| 底层丝印 | 0（底层无丝印） | 0 | — |

那 0.64 mm² 全部集中在 **LED1 的两个焊盘边缘**（每处约 0.16 mm²），是 3 mm LED 封装那圈外轮廓蹭到了焊盘开窗。嘉立创生产时会自动把阻焊开窗内的丝印裁掉，**不影响焊接，不需要修**。**结论：丝印没有实质压焊盘。**

### 8.2 极性元件的丝印标记位置（贴片/插件时的对照依据）

按 Gerber 渲染逐脚核对，丝印标记与网络极性**全部一致**：

| 位号 | 器件 | 丝印标记 | 标记在哪一侧 | 该脚网络 | 装件时怎么办 |
|---|---|---|---|---|---|
| C1 | 电解电容 | 「+」 | 左侧（x=31.75） | 1 脚 `VBAT_F`（正） | **长脚插左边**，壳体白条朝左 |
| C2 | 电解电容 | 「+」 | 左侧（x=48.25） | 1 脚 `VBAT_F`（正） | 同上 |
| D1 | SS34（SMA） | 竖线（阴极带） | 右侧（x=27.90） | 1 脚 `VBAT_F` | **色带朝右** |
| D2 | SS34（SMB） | ▷◁ 二极管符号 | 横跨两脚 | 1 脚 `AO1` / 2 脚 `AO2` | 跨在 AO1/AO2 之间，方向见下方说明 |
| LED1 | 3 mm 直插 LED | 「+」 | 右侧（x=44.25） | 2 脚 `LED_A`（阳极） | **长脚插右边**，短脚/壳体平面侧朝左（GND） |
| BUZ1 | 有源蜂鸣器 | 「+」 | 左侧（x=10.20） | 1 脚 `+5V` | **正极脚插左边** |

> **D2 方向说明**：D2 是跨在 `AO1`/`AO2` 之间的续流二极管，只有电机单方向运转时起钳位作用。若固件允许反转，反转时 D2 会正向导通形成短路——**固件必须保证电机只朝一个方向转**。这一点在固件侧要记住。

### 8.3 双排座的间距（M1 / TB6612）

| 座 | 封装 | 脚距 | 两排间距 | 实测依据 |
|---|---|---|---|---|
| M1 | 2×8 双排母 | **2.54 mm** | **2.54 mm**（两排 y = 55.73 / 58.27） | PCB 焊盘坐标 |
| U1 / U2 | 1×20 单排母 | 2.54 mm | —（单排） | 两排中心距 22.86 mm（用户实测 9 个面包板孔） |
| J6 | 1×6 单排针 | 2.54 mm | —（单排） | 焊盘 x = 69.65 / 72.19 / 74.73 / 77.27 / 79.81 / 82.35 |

> **J6 不是 NodeMCU 的插座**，只是一排 6 根针（`+3V3_WIFI` / `GND` / `USART3_TX` / `USART3_RX` / `WIFI_EN` / `WIFI_IO0`），NodeMCU 用**杜邦线**接过去，不用对插，所以 J6 不需要跟 NodeMCU 量什么尺寸。

---

## 九、立创EDA 操作顺序（版本不同菜单名可能微差）

1. 新建工程 → 建原理图
2. 在"元件库"搜标准件（电阻、电容、三极管、端子、排母），模块用"多引脚排母"代替
3. 按第四节网络表连线，标注网络名（画网络标签比拉长线清晰）
4. 原理图 → **设计管理器 / 校验**，确认无未连接引脚
5. 转 PCB，先画板框（100×80），放 4 个 M3 孔
6. 按第五节分区摆放，先放连接器和模块，再放小元件
7. 设规则：线宽、间距、过孔尺寸按第六节
8. 布线 → 铺铜（底层整块 GND）→ 丝印调整
9. DRC → 按第八节逐条过
10. 导出 Gerber + BOM + 坐标文件，上传嘉立创下单

---

## 十、封装与可焊性（打完能不能直接插上、焊上）

先纠正一个常见误解：**3D 预览不生成任何制造数据。**

工厂拿到的是 **Gerber（各层铜箔 / 阻焊 / 丝印）+ 钻孔文件 + BOM**。3D 只是给你自己检查"元件会不会打架"用的，它不参与生产。所以"把 3D 转给工厂打样"这个理解不成立。

要保证打回来能直接装，只有一件事：**原理图里每个器件的封装，必须和你要买的实物一一对应。** 立创EDA 里一个器件由三部分组成：

| 组成 | 作用 | 出错后果 |
|---|---|---|
| 符号 Symbol | 原理图上的图形与引脚 | 引脚数与实物不符，连错网络 |
| 封装 Footprint | PCB 上的焊盘尺寸与间距 | **打完焊不上**，最致命 |
| 立创编号 | 对应商城里具体物料 | BOM 下错料 |

必须做的三个动作：

1. **优先用带商城编号的标准件**，BOM 能一键下单，避免自己建库建错
2. **转 PCB 前逐个确认都有封装**，没绑封装的器件转过去会消失或报错
3. **拿卡尺量一遍实物**，尤其模块——TB6612 有 2.54 和 2.0 两种排针间距，OLED 有直排和弯排

常见封装与孔径对照：

| 元件 | 封装 | 孔径 / 说明 |
|---|---|---|
| 0805 / 0603 贴片 | R0805、C0603 等 | 无孔径 |
| 直插电阻 | AXIAL-0.4 | 孔径 0.8 mm（引脚约 0.5 mm） |
| 3 mm LED | LED-3MM | 孔径 0.9 mm，注意长短脚 |
| 6×6 轻触按键 | SW-6x6x5 | 4 脚，孔径 0.9 mm |
| 2.54 排针 / 排母 | HDR-1x4、1x5 | 孔径 1.0 mm |
| KF301 端子 | KF301-2P | 孔径 1.3 mm |
| M3 安装孔 | — | 孔径 3.2 mm，非金属化 |

丝印必须标清：**位号（R1 / C1 / U1）+ 极性标记**（二极管横杠、电解电容负极、LED 方向、连接器 PIN1）。没有丝印，焊接时只能靠猜。

---

## 十一、扩展预留（WiFi / 蓝牙 / 手机 App）

**结论：会受影响，但影响可以提前消除。** 打板后再加模块，能补的只有"飞线 + 外挂"，补不回来的是三样：**引脚、电源、天线净空**。这三样现在留成本几乎为零，不留就只能改板重打。

### 11.1 引脚：别指望 USART2，它已经被占了

STM32F103C8T6 只有三路串口：

| 串口 | 引脚 | 现状 |
|---|---|---|
| USART1 | PA9 / PA10 | 已用于调试串口 |
| USART2 | PA2 / PA3 | **已被 TB6612 的 AIN1 / AIN2 占用，且 F103 的 USART2 不能重映射** |
| USART3 | PB10 / PB11 | **当前完全空闲，这就是 WiFi 模块该走的口** |

所以现在就把 **PB10 / PB11 引到 J6**（USART3）。这是唯一"不改硬件就能接无线模块"的路，这两个脚若空着不出板，打样后只能飞线。

J6 定义（1×6P，2.54 mm，ESP8266 与 ESP32 底板都通用）：

| 脚 | 网络 | 说明 |
|---|---|---|
| 1 | `+3V3_WIFI` | 独立 3.3 V |
| 2 | `GND` | |
| 3 | `USART3_TX` | 接模块 RX |
| 4 | `USART3_RX` | 接模块 TX |
| 5 | `WIFI_EN` | 模块使能。板上**不设**上拉，靠 NodeMCU 底板自带的 10 kΩ + RST 按键 |
| 6 | `WIFI_IO0` | 烧录模式：拉低进下载。板上**不设**上拉，靠底板自带的 10 kΩ + FLASH 按键 |

> 若想让 ESP-01S 直接插在板上，另加一组 **2×4 母座**即可，但**引脚顺序必须用万用表对照实物逐脚确认**（不同批次丝印方向不一致，插错会烧模块）。
> 第一版建议只用 1×6 排针 + 杜邦线接模块底板，零风险。

### 11.2 电源：必须独立，不能挂核心板的 LDO

ESP8266 发射瞬间电流可达 300 mA，ESP32 更高（约 500 mA）。核心板上那颗 AMS1117 是给 MCU 用的，余量小、去耦只有 10 µF 级。

若 WiFi 模块的 3.3 V 直接取核心板 3.3 V 引脚，模块一发射，电源被拉低 → **MCU 复位**。现象是"一连上 WiFi 就重启"，极容易被误判成程序 bug。

正确做法：板上单独放 **AMS1117-3.3（U3）从 5 V 转 3.3 V**，配 10 µF + 0.1 µF，专供 J6。成本几毛钱，省掉一整轮排查。

### 11.3 天线：物理不可逆，必须现在留

模块天线周围需要净空，下方不能铺铜、不能走线、不能放金属件，最好让天线正对板边或伸出板外。

**这一项打板时没留，后期无法补救**，只能锯板或把模块架空飞到板外。

本版安排：右上角 30 × 20 mm 空区放 J6，其正上方沿板边留 8~10 mm 净空带，铺铜时挖空。

### 11.4 模块方案对比

| 方案 | 优点 | 缺点 | 适合 |
|---|---|---|---|
| ESP8266（ESP-01S） | 便宜、资料多、AT 指令简单 | 仅 WiFi，烧录要单独接线 | 快速联网，两周出效果 |
| ESP32-WROOM | WiFi + BLE 双模、算力强 | 稍贵、功耗高、天线占位大 | 想同时讲 BLE 与云两条链路 |
| 蓝牙模块（HC-05/06） | 最简单，手机直连 | 仅近距离，不能上云 | 纯演示 |

手机端三条链路：

1. **局域网 TCP/UDP**：手机与模块同一 WiFi，App 直连 IP。最简单，但离开该网络就看不到
2. **MQTT 云平台**（巴法云、阿里云 IoT、EMQX）：设备发到云，App 订阅。**可远程查看，演示效果好，也好讲架构**
3. **BLE 直连**：适合 ESP32，手机读特征值。近距离、低延迟

工程上推荐 **ESP8266 + MQTT** 或 **ESP32 + MQTT**：能讲清"STM32 采集控制 → ESP 联网 → 云端存储转发 → 手机 App 展示"的四层分工，比单纯说"加了个 WiFi"有价值得多。

### 11.5 一个务实建议

**WiFi 模块不要焊死**，用 1×6 排针插装（和 TB6612 同一思路）。理由：配网失败要反复烧录，插装可以拔下来用 USB-TTL 单独调试；将来换 ESP32 只换模块，不用改板。

另外，模块烧录需要 **USB-TTL 串口模块**（CH340 等）。第一版不建议把 CH340 画到板上——多一个芯片就多一个故障点，外接一根线更省事。

### 11.6 数据链路与通信协议

硬件只解决"能连"，App 能不能显示取决于**STM32 往外吐什么格式**。现在固件里 USART1 打的是给人看的调试文本：

```
Battery: 12.35V | Temp: 28.5C | V-ADC: 3245 | T-ADC: 2048
```

这种格式给 App 解析很痛苦。建议**新增一路面向机器的数据帧**，走 USART3 发给 WiFi 模块，用单行 JSON：

```json
{"v":12.35,"t":28.5,"fan":1,"alarm":0,"sim":0,"ts":12345}
```

| 字段 | 含义 |
|---|---|
| `v` | 电池电压（V，两位小数） |
| `t` | 温度（℃） |
| `fan` | 风扇档位：0 停 / 1 低速 / 2 高速 |
| `alarm` | 报警：0 正常 / 1 过压 / 2 欠压 |
| `sim` | 温度模拟模式：0 / 1 |
| `ts` | 上电后秒数，用于 App 判断数据是否新鲜 |

三件事要注意：

1. **波特率与模块一致**（建议 USART3 也用 115200）
2. **ESP8266 上电会先吐一堆乱码启动日志**（74880 或 115200 波特率），STM32 侧解析要做容错，不能一见非 JSON 就死等
3. **发送频率别太高**，1 Hz 足够；WiFi 发包太频繁会占 CPU、也增加功耗

App 侧拿数据的三种方式：

| 方式 | 实现 | 适用 |
|---|---|---|
| 局域网 HTTP | ESP8266 跑 Web Server，App 定时 GET `/api/data` | 同一 WiFi 下最简单 |
| 局域网 WebSocket | ESP 主动推送，App 实时刷新 | 想要秒级响应 |
| 云端 MQTT | ESP 发布到主题，App 订阅 | **可远程查看，推荐** |

**结论：只做"同一 WiFi 下看数据"，一个 ESP8266 就够了，不需要服务器。想要随时随地看，再加一个免费 MQTT 平台当中转，仍然不需要自己写服务器。**

---

## 十二、下一步

- [x] **修正 D1 位置**（2026-10-22 完成，见第四节说明框）
- [x] **锁定蜂鸣器型号**（2026-10-22 完成，BUZ1 = C17701079 有源，见 v1.4 修订记录）
- [x] 确认第〇节三个前提（2026-10-22 定案：核心板 + TB6612 模块 + K7805）
- [x] **确认是否在这一版就留 WiFi 预留区**（已留，J6 + U3 + C12/C13，见第十一节）
- [ ] 定 WiFi 模块型号（ESP8266 / ESP32），据此锁定 J6 走线 → **实际已下单 NodeMCU V3 CH340 Type-C，等货到核对针脚**
- [ ] 固件新增 USART3 数据帧输出（JSON，见 11.6）
- [x] 确认板子尺寸与安装方式（100 × 80 mm，裸板 + 4 根 M3×8~10 尼龙柱 + M3×6 螺丝，不装盒）
- [x] 画原理图后贴出来一起评审网络表（原理图 4 页已完成，PDF 见 `05_交付产物/原理图/`）
- [x] **PCB 布局 / 布线 / 铺铜 / DRC / Gerber**（2026-10-23 全部完成）
- [ ] **下单**：嘉立创 PCB（Gerber 已就绪）+ 立创商城 22 种料号 + 淘宝 NTC 探头 / NodeMCU
- [ ] 拿实物核对核心板朝向（PCB 上 1 脚朝右、USB 朝右；若实物相反需整组翻 180° 重摆）
- [ ] 打样回来先做**上电前通断检查**，再分级上电（先 Buck 空载测 5 V，再插核心板）

---

**文档版本**：v1.9（2026-10-23 丝印重叠核算 + 极性丝印标记定位 + 双排座间距实测）
**创建日期**：2026-10-21
**关联固件**：v2.0.0（`02_固件代码/STM32F103C8T6/LYC1`）

**v1.9 修订记录**

1. **新增 8.1「丝印与阻焊开窗的重叠检查」**：把 Gerber 的 GTO 与 GTS 栅格化成 0.05 mm 位图求交，顶层丝印总面积 269.68 mm²，落在开窗内仅 **0.64 mm²（0.2%）**，全部在 LED1 两个焊盘边缘。嘉立创会自动裁掉，无需修改。底层无丝印。
2. **新增 8.2「极性元件的丝印标记位置」**：逐脚核对 C1/C2/D1/D2/LED1/BUZ1 的丝印标记侧与网络极性，**六项全部一致**。C1/C2 的「+」在左侧（1 脚 `VBAT_F` 正极）；D1 阴极带在右侧（1 脚 `VBAT_F`）；LED1 的「+」在右侧（2 脚 `LED_A` 阳极）；BUZ1 的「+」在左侧（1 脚 `+5V`）。
3. **补充 D2 方向风险说明**：D2 跨接 `AO1`/`AO2` 做续流，电机单向运转时有效；若固件允许反转，反转时 D2 正向导通会短路。**固件必须保证单向。**
4. **新增 8.3「双排座的间距」**：M1（TB6612 座）脚距 2.54 mm、**两排间距 2.54 mm**（焊盘 y = 55.73 / 58.27）；J6 是 1×6 单排针（x = 69.65~82.35），**不是 NodeMCU 的插座**，NodeMCU 走杜邦线，不存在对插间隙问题。
5. **第八节检查单**：丝印一项打勾；3D 预览一项补上「只看 4 类高个子元件」的具体指引。

**v1.8 修订记录**

1. **PCB 布局 + 布线 + 铺铜 + DRC 全部完成**（2026-10-23）。39 元件落位、200 段走线、52 个过孔、双面 GND 铺铜 2 块、DRC 0 违规。详见新增的「七之二、实际布线结果」。
2. **第七节打样参数补「实际落实情况」列**：板厚 1.6 mm / 铜厚 1 oz / 绿色阻焊 / 喷锡，四项均为嘉立创不加价档；尺寸定 100 × 80 mm；安装孔 4 个 M3 非金属化。
3. **新增电源走线宽度表**：`VBAT` / `VBAT_FUSE` / `VBAT_F` 加粗到 1.5 mm，`+5V` 主干 1.0 mm，信号保持 0.254 mm。依据 1 oz 铜在温升 10 ℃ 下 1 mm 宽约 2.3 A，电机堵转约 1 A。
4. **Gerber 已导出**到 `05_交付产物/Gerber/Gerber_下单版_100x80_2L.zip`。下单包剔除了 7 个非制造文件（`TopPasteMask`、`Document`、`DrillDrawing` 与 4 个 `Fabrication_Colorful*` 彩色丝印层）。板框实测 100.000 × 80.001 mm，NPTH 4 个 3.19989 mm。
5. **过孔焊环统一到 0.61 mm 盘 / 0.3 mm 孔**（焊环 0.155 mm）。原有两个模拟区孤岛修复用的过孔焊盘只有 0.5 mm（焊环 0.099 mm，低于嘉立创双面板最小 0.13 mm），已改为标准尺寸，改后 DRC 仍为 0。
6. **第八节下单前检查单逐条打勾**，未勾的四项都是必须拿实物或目视确认的（丝印压焊盘、极性方向、排母间距、3D 预览）。

**v1.7 修订记录**

1. **删除 `J4`（SWD 调试，1×4P 排针 C2905435）**。根因：`SWDIO`、`SWCLK` 在网表里**各自只有 J4 自己的一个脚**，没有任何 MCU 引脚——野火核心板 40 针排母未引出 PA13/PA14。这块板上插 DAP 进去识别不到芯片，属无效接口。调试与烧录改走核心板自带调试排针与 Type-C。
2. **网络表同步**：`SWDIO`、`SWCLK` 两个网络整体消失；`+3V3` 去掉 `J4-1`、`GND` 去掉 `J4-4`。元件总数 **40 → 39**，网络总数 **31 → 29**。
3. **DRC 由 76 项降至 67 项**：`SHOWDANDLING` 4 → 2、`NETOBJECTONGRID` 70 → 63，均为删除悬空网络与导线后的净减少；`ATTRMATCHCODE` 1、`CHECKFLOATPIN` 1 不变（后者是核心板 40 针未用脚，与 J4 无关）。
4. **原理图 Sheet4 说明文字同步重建**：原 38 条文本是 4 套重复叠加（同 Sheet2 的老毛病），已整组清除并按现行内容重建 9 行，去掉所有 J4 / SWD 描述。

**v1.6 修订记录**

1. **删除 `RN1`（NTC 直插件 C9900004066），新增 `J7`（KF301-2P，C9900016950）**。NTC 改为外购防水探头经端子外接，探头贴电池壳体。改因：直插珠子测的是环境温度而非电芯温度，且四根引线反复弯折必断在根部。
2. **网络表同步**：`PA5` = R3-2 / **J7-1** / C14-1 / U1-9；`GND` 中的 `RN1-2` 换成 **J7-2**。网表已按 Protel2 实际导出核对，元件总数仍 40，DRC 76 项与换料前逐项一致、零新增。
3. **原理图 Sheet2 接线**：J7 放在原 RN1 位置（中心 620,340），`rot=0 / mir=false`，1 脚在上、2 脚在下。因端子两脚间距 2.54 mm 而原 RN1 符号跨 10.16 mm，两根导线不再直接落到引脚，各加一根 3 段短跳线从原节点引到 J7-1 / J7-2。
4. **明确排除江科大套件的「热敏电阻传感器模块」**：那是 LM393 比较器模块（VCC/GND/DO/AO），AO 为低阻输出会与板上 R3 上拉对打，且自带一路分压。必须买**裸 NTC 探头**，不是模块。
5. **新增布局约束第 5 条**：J7 靠板边、进线口朝外，距板边 2~6 mm。

**v1.5 修订记录**

1. **M2 从「MP1584 迷你模块 + 1×4P 排母」改为「K7805-1000R3 开关稳压模块 + SIP-3 直插」**（C111280）。
   换料原因有两条硬约束：① 淘宝 22×17 迷你 MP1584 模块的焊盘「side-to-side 是 2.54，end-to-end 不是 2.54 整数倍」，**物理上插不进任何标准排母，也插不进面包板**；② 这类模块没有规格书、没有引脚定义，商家客服明确回复「只有详情页的参数」，无法据此确定封装。K7805 是工业模块，有完整 PDF（选型表、纹波、效率、降额曲线），SIP-3 引脚落在 2.54 网格上，且与 LM78xx 引脚兼容。
2. **M2 引脚由 4 脚变 3 脚**：`M2-1 = Vin` 接 `VBAT_F`，`M2-2 = GND`，`M2-3 = Vout` 接 `+5V`。原 4 脚符号的两个 GND 脚（`M2-2` / `M2-4`）合并为 `M2-2`，网络表已同步。
3. **不装排母，直接焊**。3 脚立式器件的引脚受力集中，插排母会晃、易裂；K7805 自带短路保护与自动恢复，损坏概率低，坏了整块更换。
4. **新增两条电气约束**：
   - K7805 输入下限 **8 V**。3S 电池放空按 9.0 V 截止时余量仅 1 V；若日后把截止电压下探到 8.4 V（2.8 V/cell），模块会先跌出稳压。
   - 纹波 **75 mVp-p**（K7805）高于迷你模块的 20–30 mV。经 AMS1117 的 PSRR（520 kHz 约 40 dB）与 100 nF 去耦后，到 ADC 端不足 1 mV，对采样无实质影响；但 `+5V` 的去耦电容 C4~C10 不可省。
5. **尺寸变化**：模块本体 11.5 × 9 × 17.5 mm（立式），比原 MP1584 模块（22 × 17 × 4）占地小 60%，但高度增加 13.5 mm。裸板使用无影响；日后若装盒需预留该高度。

**v1.4 修订记录**

1. **BUZ1 换成 C17701079（HYE1206-05ST）**。原 C9900008742 是 EDA 库里的第三方符号（`chenzj1:Buzzer_12x9.5RM6.5`），`Description` 为空、商城查无此号，无法确认有源还是无源；同封装 SEA-1285F 系列在库里标注「无源/电磁式」，风险不可接受。新料库描述明确「驱动方式：有源（内含驱动线路），5 V，2.6 kHz，80 dB」，与 `+5V` 直接匹配，固件保持「拉高即响」。
2. **续流二极管不加**：有源蜂鸣器内含驱动线路，Q1 切换模块输入端而非裸线圈。若日后实测有干扰再补 1N4148。
3. 封装由 `BUZ-TH_BD12.0-P6.50-D0.6` 变为 `BUZ-TH_BD12.0-P7.60-D0.6`（脚距 6.5 → 7.6 mm），PCB 尚未开始，无返工成本。

**v1.3 修订记录**

1. **M1 锁定 C42420228**（DS1023-02-2x8SF11）。原通用件对应的 C9900000696 是库里残件，网表只导出三行、`Supplier Part` 恒为空，改属性无效。已换完整器件重画，16 脚网络逐个复核通过。
2. **`WIFI_EN` / `WIFI_IO0` 明确不设板上拉**：依赖 NodeMCU V3 底板自带的 10 kΩ 上拉，板上再加会并联成 5 kΩ，无收益。这两个网络只有 J6 一个引脚，DRC 的单引脚告警属有意为之。
3. Sheet3 内部三根连线由自动名 `$3N317/$3N319/$3N322` 改为 `Q1_B` / `Q1_C` / `LED_A`。

**v1.2 修订记录**

1. **修正 D1 接法（方案 A）**：原图纸 D1 只串在 Buck 一路，TB6612 VM 与 C1/C2 两颗电解挂在阳极侧，电池反接时无保护。现改为「保险丝 → D1 → 主母线」，全板统一受保护。已改原理图并复核网表，DRC 无新增告警。
2. 网络表：`VBAT_IN` 改名 `VBAT_FUSE`（缩到 `F1-2 → D1-2` 一段）；`VBAT_F` 重新定义为 D1 阴极侧主母线（含 Buck、TB6612 VM、电解、分压上臂）。

**v1.1 修订记录**

1. 第四节网络表把原文 `+5V` 一行拆分——原文写法等于把防反接二极管 D1 两端短接。
2. 删除 `VBAT_ADC`、`NTC_GND` 两个不存在的网络名（实际已分别并入 `VBAT_F`、`GND`）。
3. 第三节器件清单按网表重排：U1 拆成 U1/U2 两个 1×20P 排母；M1 数量 2→1；F1 耐压 16→24 V；C3、C12 耐压 16→25 V；100 nF 数量 9→11 并拆出 C11/C14/C15；J3 排针→排母；补充 LCSC 列。
4. 全文引脚号统一为「位号-脚号」，可直接与网表逐条对照。
