yunchuanli003/stm32-3s-battery-monitor/04_测试验证/测试用例/20260604_按键控制功能测试用例_v1.0.md

# 按键控制功能测试用例

## 测试目标

验证 KEY2 单键控制功能（长按停止、短按开启）是否正常工作，特别是修复"第二次长按不打印信息"的问题。

---

## 测试环境

| 项目 | 配置 |
|---|---|
| **MCU** | STM32F103C8T6 |
| **按键** | KEY2 (PC13) |
| **串口** | USART1, 115200, 8N1 |
| **系统时钟** | 72MHz |
| **串口调试助手** | 野火多功能调试助手 |
| **测试日期** | 2026-06-04 |
| **被测固件** | v2.0.0（面包板验证版） |

---

## 测试前准备

1. ✅ 烧录最新的固件到开发板
2. ✅ 打开串口调试助手，波特率 115200
3. ✅ 按复位键，确认能看到开机欢迎信息
4. ✅ 确认能看到电压数据正常打印

---

## 测试用例列表

### 测试用例 1：第一次长按停止系统

| 项 | 内容 |
|----|---|
| **测试ID** | TC-001 |
| **测试目的** | 验证第一次长按能否正常停止系统并打印信息 |
| **前置条件** | 系统正在运行，电压数据正常输出 |
| **测试步骤** | 1. 长按 KEY2 按键<br>2. 按住约 3 秒<br>3. 释放按键 |
| **预期结果** | 1. 长按约3秒时，立即打印 `[系统] 系统已经停止`<br>2. 电压数据停止输出<br>3. LED 和蜂鸣器关闭<br>4. 蜂鸣器"滴"一声确认 |
| **实际结果** | 长按约 3 s 打印 `[系统] 系统已经停止`；电压数据停止输出；LED 与蜂鸣器关闭，蜂鸣器短鸣一声 |
| **是否通过** | ✅ 通过 |

---

### 测试用例 2：系统停止状态下再次长按

| 项 | 内容 |
|----|---|
| **测试ID** | TC-002 |
| **测试目的** | 验证系统停止后再次长按不会误触发短按 |
| **前置条件** | 系统已停止（执行完 TC-001） |
| **测试步骤** | 1. 再次长按 KEY2 按键<br>2. 按住约 3 秒<br>3. 释放按键 |
| **预期结果** | 1. **不打印**任何系统信息（因为已经停止）<br>2. 释放按键后 **不会** 误触发短按<br>3. 系统保持停止状态 |
| **实际结果** | 再长按 3 s 无任何打印；释放后未误触发短按；系统保持停止 |
| **是否通过** | ✅ 通过 |

---

### 测试用例 3：短按开启系统

| 项 | 内容 |
|----|---|
| **测试ID** | TC-003 |
| **测试目的** | 验证短按能否正常开启系统 |
| **前置条件** | 系统已停止（执行完 TC-002） |
| **测试步骤** | 1. 短按 KEY2 按键（< 1秒）<br>2. 释放按键 |
| **预期结果** | 1. 释放后立即打印 `[系统] 系统已经开启`<br>2. 电压数据恢复输出<br>3. 蜂鸣器"滴"一声确认<br>4. **关键验证**：不会出现"系统已经停止"的延迟信息！ |
| **实际结果** | 释放后立即打印 `[系统] 系统已经开启`；电压数据恢复输出；未出现延迟的停止信息 |
| **是否通过** | ✅ 通过 |

---

### 测试用例 4：第二次长按停止（验证修复是否生效）

| 项 | 内容 |
|----|---|
| **测试ID** | TC-004 |
| **测试目的** | 验证第二次长按能否正常打印停止信息 |
| **前置条件** | 系统已恢复运行（执行完 TC-003） |
| **测试步骤** | 1. 长按 KEY2 按键<br>2. 按住约 3 秒<br>3. 释放按键 |
| **预期结果** | 1. 长按约3秒时，**立即打印** `[系统] 系统已经停止`<br>2. 电压数据停止输出<br>3. **关键验证**：信息立即显示，不会延迟到下次短按！ |
| **实际结果** | 第二次长按约 3 s 立即打印停止信息，未延迟到下次短按 |
| **是否通过** | ✅ 通过 |

---

### 测试用例 5：第二次短按开启

| 项 | 内容 |
|----|---|
| **测试ID** | TC-005 |
| **测试目的** | 验证第二次短按能否正常开启 |
| **前置条件** | 系统已停止（执行完 TC-004） |
| **测试步骤** | 1. 短按 KEY2 按键（< 1秒）<br>2. 释放按键 |
| **预期结果** | 1. 释放后立即打印 `[系统] 系统已经开启`<br>2. 电压数据恢复输出<br>3. 只打印开启信息，不会打印停止信息 |
| **实际结果** | 立即打印开启信息，未出现停止信息 |
| **是否通过** | ✅ 通过 |

---

### 测试用例 6：连续多次切换

| 项 | 内容 |
|----|---|
| **测试ID** | TC-006 |
| **测试目的** | 验证连续多次切换是否稳定 |
| **前置条件** | 系统正在运行 |
| **测试步骤** | 1. 长按停止 → 短按开启（循环3次）<br>2. 观察每次操作的打印输出 |
| **预期结果** | 1. 每次长按都立即打印"系统已经停止"<br>2. 每次短按都立即打印"系统已经开启"<br>3. 没有延迟打印，没有重复打印 |
| **实际结果** | 3 轮共 6 次切换，每次打印及时，无延迟、无重复 |
| **是否通过** | ✅ 通过 |

---

### 测试用例 7：边缘测试 - 长按 2.9 秒（差一点到3秒）

| 项 | 内容 |
|----|---|
| **测试ID** | TC-007 |
| **测试目的** | 验证长按时间阈值是否正确 |
| **前置条件** | 系统正在运行 |
| **测试步骤** | 1. 长按 KEY2 约 2.5-2.9 秒<br>2. 释放按键 |
| **预期结果** | 1. 不会触发停止（时间不够）<br>2. 因为系统还在运行，短按也不会触发开启<br>3. 系统保持运行状态 |
| **实际结果** | 2.9 s 未触发停止，系统保持运行 |
| **是否通过** | ✅ 通过 |

---

### 测试用例 8：边缘测试 - 长按 3.1 秒（刚好到3秒）

| 项 | 内容 |
|----|---|
| **测试ID** | TC-008 |
| **测试目的** | 验证长按时间阈值是否正确 |
| **前置条件** | 系统正在运行 |
| **测试步骤** | 1. 长按 KEY2 约 3.1-3.5 秒<br>2. 释放按键 |
| **预期结果** | 1. 约3秒时打印"系统已经停止"<br>2. 系统停止运行 |
| **实际结果** | 3.1 s 触发停止，系统停止运行 |
| **是否通过** | ✅ 通过 |

---

## 关键验证点（修复前后对比）

| 验证项 | 修复前（bug） | 修复后（预期） |
|---|---|---|
| **TC-002 长按后释放** | 误触发短按，延迟打印停止信息 | 不触发短按，不打印 |
| **TC-003 短按开启** | 先打印"停止"再打印"开启" | 只打印"开启" |
| **TC-004 第二次长按** | 不打印停止信息 | 立即打印停止信息 |

---

## 测试结果汇总

| 测试用例 | 预期结果 | 实际结果 | 是否通过 |
|---|---|---|---|
| TC-001 第一次长按停止 | 长按 3 s 打印停止、数据停输出、声光关闭 | 与预期一致 | 通过 |
| TC-002 停止后再次长按 | 长按后无打印、释放未误触发短按 | 与预期一致 | 通过 |
| TC-003 短按开启 | 立即开启，无延迟的停止信息 | 与预期一致 | 通过 |
| TC-004 第二次长按停止 | 第二次长按立即打印停止 | 与预期一致 | 通过 |
| TC-005 第二次短按开启 | 只打印开启信息，无停止信息 | 与预期一致 | 通过 |
| TC-006 连续多次切换 | 3 轮切换输出稳定 | 无延迟、无重复 | 通过 |
| TC-007 长按2.9秒 | 长按 2.5–2.9 s 不应触发 | 2.9 s 未触发 | 通过 |
| TC-008 长按3.1秒 | 长按 3.1–3.5 s 应触发 | 3.1 s 触发 | 通过 |

### 总体测试结论

| 项 | 结果 |
|----|---|
| **通过用例数** | 8 / 8 |
| **失败用例数** | 0 / 8 |
| **总体评价** | 按键状态机符合设计预期，两个时间边界（2.9 s 未触发 / 3.1 s 触发）判定准确 |
| **备注** | TC-001 ~ TC-005 为按键状态机修复后的复测结果。修复前 TC-002（长按释放后误触发短按、延迟打印停止信息）与 TC-004（第二次长按不打印停止信息）实测不通过；失败现象与修复方式见上文「关键验证点（修复前后对比）」与「问题排查指南」 |

---

## 问题排查指南

如果测试不通过，按以下步骤排查：

### 现象 A：第二次长按不打印信息

1. 确认 TC-002 是否通过（停止后长按不触发短按）
2. 如果 TC-002 不通过，检查 `key2_long_triggered` 是否在 system_running == 0 时也被设置

### 现象 B：短按时出现延迟的停止信息

1. 这是之前 bug 的典型现象
2. 确认代码中 `key2_long_triggered = 1` 是否在 `if(system_running == 1)` 外面

### 现象 C：长按时间不对

1. 检查 `key2_long_press_cnt < 60` 的判断
2. 60 * 50ms = 3秒，确认主循环延时是 50ms

---

## 附录：代码关键位置参考

| 功能 | 文件 | 行号 |
|---|---|---|
| 长按标志设置 | main.c | 第124行 |
| 停止操作执行 | main.c | 第127-142行 |
| 短按开启判断 | main.c | 第151行 |
| 长按时间阈值 | main.c | 第117行 |
| 状态重置 | main.c | 第169-173行 |
