yunchuanli003/stm32-3s-battery-monitor/03_硬件设计/20261022_采购清单_v1.0.md

# 采购清单（WiFi 验证阶段）

> 范围：只覆盖「让 STM32 连上网」这一步要买的东西。
> PCB 打样焊接用的贴片阻容、端子、排母**不在本清单内**，见 `PCB设计/20261021_PCB打样设计输入_v1.0.md` 第三节。
> 状态：**已作废** —— 被 `20261023_采购清单_v2.0.md` 替代（本版仅 WiFi 验证阶段的局部采购，v2.0 为全量三单）。保留仅作决策留档。

---

## 〇、先说结论

已选定 **方案 1**：PCB 上 J6 保持 1×6P 排针，NodeMCU 只做开发验证，用杜邦线接过去。

这个选择的直接后果是——**现在只需要买一块开发板 + 一把杜邦线，PCB 和原理图一个字都不用改。**

| | 方案 1（已选） |
|---|---|
| 原理图改动 | 无 |
| PCB 改动 | 零，板框仍是 100 × 80 mm |
| 预留区 30 × 20 mm | 留给天线净空，不装模块 |
| 换模块 | 拔线即可 |

---

## 一、下单清单

| # | 物品 | 规格 | 数量 | 参考价 | 搜索词 |
|---|---|---|---|---|---|
| 1 | NodeMCU 开发板 | V3，ESP8266，**4 MB Flash**，CH340，**Type-C 口** | 2 | 12–22 元/块 | `NodeMCU V3 CH340 ESP8266 开发板` |

实付约 **26 元**（12.9 × 2，包邮）。

### 为什么是 2 块

USB 座是这块板上机械强度最差的部分，反复插拔容易脱焊。答辩前一周坏掉，重买要等快递。多备一块的成本是十几块，比返工便宜。

### 为什么只买这一项

2026-10-22 核对库存：江科大套件与野火小智简配套餐**实物均在手上**，其余配件已覆盖。

| 物品 | 来源 | 数量 |
|---|---|---|
| 母对母杜邦线 | 江科大第 7 项（40 根）+ 野火第 15 项（20 根） | **60 根** |
| Type-C 数据线 | 野火第 12 项 | 2 根 |
| DAP 调试器 | 野火第 2 项 | 1 |
| 面包板 | 江科大第 4 项 / 野火第 10 项 | 各 1 |
| TB6612 电机驱动模块 | 江科大第 25 项 | 1 |
| 130 电机 + 三叶风扇叶 | 江科大第 26、27 项 | 各 1 |
| OLED 0.96" | 江科大第 2 项 | 1 |

接 J6 到 NodeMCU 只需 **3 根**母对母线（GND / TX / RX），60 根里随便挑，长度 21 cm 也够。

> 面包板跳线、面包板插线（江科大第 5、18 项，野火第 11 项）都是短的单股硬线，**不能替代杜邦线**：做不出母头，也插不进 2.54 排针。

---

## 二、四条硬指标（不达标就别下单）

| 看什么 | 要什么 | 不达标会怎样 |
|---|---|---|
| 主控 | ESP8266，板载 ESP-12E/F，**4 MB Flash** | 1 MB 是老版 V2，刷完固件空间紧张 |
| 串口芯片 | CH340 / CH340C / CH343 | 标 CP2102 的也能用，驱动不同 |
| USB 口 | **Type-C 优先**，Micro-USB 次之 | Micro 座焊盘小，斜插容易连根拔起 |
| 单价 | 12–22 元 | 低于 10 元大概率是拆机板或翻新板 |

卖家页面上最好能看到**实物照片**（不是渲染图）、有**销量和真实评价**、明确写了 Flash 大小。

---

## 三、三个必踩的坑（按概率排序）

### 坑 1：附送的数据线是纯充电线

新手第一大坑。插上后设备管理器毫无反应，会误以为板子坏了。

- Type-C 版：直接用自己的手机数据线，绕开这个问题
- Micro-USB 版：下单前问清是不是数据线，或者干脆自备

**排查顺序永远是：先换线，再装驱动。**

### 坑 2：CH340 驱动装不上

Win11 的「内存完整性 / 内核隔离」会拦掉旧版 CH340 驱动，表现为驱动装了但设备带黄色感叹号。

- 去 WCH 官网 `wch.cn` 下 `CH341SER.EXE` 最新版
- 别用第三方下载站的版本
- 装完拔插一次板子，才会出现 COM 口

### 坑 3：买错型号

三个名字看着像，实际完全不是一回事：

| 名称 | 是什么 | 能不能用 |
|---|---|---|
| **ESP8266 ESP-01S** | 8 针小模组，**没有 USB** | 单独买回来插不上电脑，用不了 |
| **NodeMCU V3** | 30 针开发板，带 USB、带 LDO、带自动下载电路 | **要买的就是这个** |
| **ESP32** | 另一颗芯片，引脚和现有资料全对不上 | 别因为「性能更强」换方案 |

---

## 四、到货验货（5 分钟，三步）

按顺序做，任何一步不过就停下来查，**不要往下走到 STM32 联调**。

### 步骤 1：认串口

插 USB → 打开设备管理器 → 端口（COM 和 LPT）

- 出现 `USB-SERIAL CH340 (COMx)` → **通过**
- 出现带黄色感叹号的未知设备 → 驱动问题，看坑 2
- 什么都不出现 → 先换线，再看是不是 USB 口供电不足（换主机后置口）

### 步骤 2：确认芯片活着

串口助手打开刚认到的 COM 口，波特率 **115200**，按一下板子上的 **RST**。

- 刷出一串乱码或启动信息 → **通过**（ESP8266 启动日志波特率不一定是 115200，乱码是正常的，说明有数据在往外吐）
- 完全没反应 → 试 74880 波特率；仍无输出则模块可能有问题

### 步骤 3：确认能进下载模式

按住 **FLASH** 不放 → 按一下 **RST** → 松开 FLASH。

配合 `esptool.py` 或 Arduino IDE 能看到芯片信息（Flash 大小、MAC）→ **通过**，这块板可以刷固件了。

> 把三步的结果和 COM 口号记下来，后面配 Arduino IDE / 写固件都要用。

---

## 五、这次不买的（避免重复花钱）

| 物品 | 为什么先不买 |
|---|---|
| **母对母杜邦线** | 两套件合计 60 根，够用 |
| **Type-C 数据线** | 野火套件已含 2 根 |
| **面包板** | 两套件各含 1 块 |
| **ESP-01S 模组** | 等 NodeMCU 和 STM32 联调通过，再决定答辩时板子上要不要放模组形态 |
| **ESP-01S 转接底板** | 同上，配套才买 |
| **USB-TTL 串口模块（CH340 独立版）** | NodeMCU 自带 CH340，开发阶段用不上 |
| **PCB 贴片阻容、端子、排母** | 属于打样物料，等原理图和 PCB 定稿后一次性下单 |

---

## 六、到货之后的顺序（先看，不用现在做）

1. 单独给 NodeMCU 通电，串口能打印 → 确认模块本身没问题
2. 刷一个最小固件（串口透传），确认能收发
3. 与 STM32 联调：NodeMCU TX → PB11，NodeMCU RX ← PB10，**GND 必须共地**
4. 波特率两边都设 115200，先跑通「STM32 发一行，电脑上看到一行」
5. 再接 WiFi、再谈 JSON 数据帧、再谈 MQTT

**供电红线：NodeMCU 只用 USB 供电。** 不要从 STM32 板子的 3V3 引线过去——WiFi 发射峰值 300 mA，板载 LDO 撑不住，现象是「一连 WiFi 就重启」，极易误判成程序 bug。

---

## 七、接线对照（画在纸上贴桌上）

```
NodeMCU                     STM32 板 J6
────────                    ────────────
GND      ────────────────   GND      (J6-2)
D10/TX   ────────────────   PB11     (J6-4, USART3_RX)
D9/RX    ────────────────   PB10     (J6-3, USART3_TX)
（不接）                    +3V3_WIFI (J6-1)   ← 开发阶段悬空
（不接）                    WIFI_EN   (J6-5)
（不接）                    WIFI_IO0  (J6-6)
```

J6-1 的 `+3V3_WIFI` 那根**不要接**：NodeMCU 有自己的 USB 供电和 LDO，两边同时往同一根 3.3 V 上灌电会打架。

---

**文档版本**：v1.0
**创建日期**：2026-10-22
**上游决策**：WiFi 模块三方案对比，选定方案 1
**关联文档**：`PCB设计/20261021_PCB打样设计输入_v1.0.md`（第十一节 扩展预留）
