yunchuanli003/stm32-3s-battery-monitor/03_硬件设计/20261023_采购清单_v2.0.md

# 采购清单（2026-10-23 归总）

> 依据：`20261021_PCB打样设计输入_v1.0.md` **v1.7** 第三节器件清单（39 个元件 / 22 种料号）
> 状态：原理图已冻结（四页 39 元件 29 网络），PCB 未开始布局
> 用途：一次性买齐，避免二次下单再付一遍运费
> 版本：**v2.0**，替代 `20261022_采购清单_v1.0.md`（原版只覆盖 WiFi 验证阶段，本版扩展为全量三单）

---

## 〇、结论先行

一共 **三单**，顺序不能颠倒：

| 单 | 平台 | 内容 | 什么时候下 |
|---|---|---|---|
| **第 1 单** | 立创商城 | 39 个元件的散件 + 备件 + K7805 | **现在就能下**，不依赖 PCB |
| **第 2 单** | 淘宝 | NTC 防水探头 ×2、NodeMCU V3 ×2 | **现在就能下**，不依赖 PCB |
| **第 3 单** | 嘉立创 PCB | 100×80 空板 5 片 | **Gerber 已导出，可以下单**（见第三节） |

第 1、2 单现在下，等 PCB 打样回来元件已经在手上，不会卡住。

---

## 一、第 1 单：立创商城（元件散件）

### 1.1 元件明细

「设计用量」= 这块板子实际要焊几个；「建议买」= 加上损耗与备件的采购量。贴片件 0603/0805 手焊容易吹飞、立碑，**多买是必须的**。

| # | 位号 | 器件 | 规格 | 封装 | 设计用量 | 建议买 | LCSC |
|---|---|---|---|---|---|---|---|
| 1 | U1 / U2 | 核心板座 | 2.54 mm **1×20P 排母** | 直插 | 2 | 2 | **C50984** |
| 2 | U3 | LDO（WiFi 专用） | AMS1117-3.3 | SOT-223 | 1 | 2 | **C5346136** |
| 3 | M1 | TB6612 模块座 | 2.54 mm 2×8P 双排母 DS1023-02-2x8SF11 | 直插 | 1 | 1 | **C42420228** |
| 4 | M2 | 5V 降压模块 | K7805-1000R3（8–36V 入 / 5V 1A 出） | SIP-3 直插 | 1 | **2** | **C111280** |
| 5 | F1 | 自恢复保险丝 | 1.5 A / **24 V** | 1812 | 1 | 2 | **C78695** |
| 6 | D1 | 肖特基（防反接） | SS34 | SMA | 1 | 2 | **C9900023345** |
| 7 | D2 | 双向 TVS | SMBJ15CA | SMB | 1 | 2 | **C330064** |
| 8 | C1 / C2 | 电解电容 | 100 µF / 25 V | 直插 φ6.3 | 2 | 3 | **C49304911** |
| 9 | C3 | 陶瓷电容 | 22 µF / **25 V** | 0805 | 1 | 2 | **C45783** |
| 10 | C4~C11、C13~C15 | 陶瓷电容 | 100 nF / 50 V X7R | 0603 | **11** | **20** | **C14663** |
| 11 | C12 | 陶瓷电容 | 10 µF / **25 V** | 0805 | 1 | 2 | **C15850** |
| 12 | R1 | 电阻（分压上臂） | 51 kΩ ±1% | 0805 | 1 | 2 | **C17737** |
| 13 | R2 / R3 / R4 | 电阻 | 10 kΩ ±1% | 0805 | 3 | 6 | **C17414** |
| 14 | R5 / R6 | 电阻 | 1 kΩ | 0603 | 2 | 4 | **C21190** |
| 15 | Q1 | NPN 三极管 | S8050 | SOT-23 | 1 | 2 | **C2931719** |
| 16 | BUZ1 | 有源蜂鸣器 | HYE1206-05ST，5V，2.6kHz，Φ12，脚距 7.6 | 直插 | 1 | 1 | **C17701079** |
| 17 | LED1 | 发光二极管 | Φ3 mm 红 | 直插 | 1 | 3 | **C9900011189** |
| 18 | SW1 | 轻触按键 | 6×6×5，四脚 | 直插 | 1 | 2 | **C18078025** |
| 19 | J1 / J2 / J7 | 接线端子 | KF301-2P | 直插 | 3 | 4 | **C9900016950** |
| 20 | J3 | OLED 接口 | 2.54 mm 1×4P **排母** | 直插 | 1 | 1 | **C5138830** |
| 21 | J5 | 串口 | 2.54 mm 1×3P 排针 | 直插 | 1 | 1 | **C2932698** |
| 22 | J6 | WiFi 接口 | 2.54 mm 1×6P 排针 | 直插 | 1 | 1 | **C37208** |

**校验**：设计用量合计 = 2+1+1+1+1+1+1+2+1+11+1+1+3+2+1+1+1+1+3+1+1+1 = **39**，与 BOM 一致。

### 1.2 四个必须留意的点

1. **M2 买 2 个**（¥15.49/个，已核实）。K7805 是立式 SIP-3 直接焊在板上，一旦焊坏或击穿就得整块换，手上没有备份会卡住整个进度。
2. **C14663 要 11 个，建议买 20 个**。0603 的 100 nF 是这块板用得最多的料，手焊时被镊子夹飞、被烙铁带走的概率不低，单价几分钱，多买不心疼。
3. **U1/U2 必须是两根独立的 1×20P 排母**（C50984），不能买 2×20 一体座。野火核心板是两条 20 脚单排针，一体座插不进去。
4. **不要买任何「模块」形态的降压件**。之前那批淘宝 22×17 迷你 MP1584 模块的焊盘端到端不在 2.54 网格上，插不进排母也插不进面包板，且无规格书——已全额退款。K7805 是工业模块，有完整 PDF。

### 1.3 已删除，不用买

| 曾经要买 | 现在 | 原因 |
|---|---|---|
| J4 SWD 排针（C2905435） | **取消** | 野火核心板 40 针排母未引出 PA13/PA14，板上 SWD 口接不到 MCU，属无效接口（2026-10-23 删除） |
| RN1 NTC 直插件（C9900004066） | **取消** | 改为 J7 端子外接防水探头，探头在淘宝买（见第 2 单） |

---

## 二、第 2 单：淘宝（模块与传感器）

这两个东西立创商城没有合适的，必须淘宝买。

| 物品 | 规格要求 | 数量 | 参考价 | 验收要点 |
|---|---|---|---|---|
| **NTC 温度探头** | 10 kΩ **B=3950**，防水型（不锈钢管封装），线长 0.5–1 m，**两线** | 2 根（通常一份 2 根，等于买 1 份） | 几元一份 | **必须是裸 NTC 两线探头**。不要买「热敏电阻传感器模块」，那是 LM393 比较器板（VCC/GND/DO/AO 四脚），AO 是低阻输出，会和板上 R3 的上拉对打，还自带一路分压，读数全错 |
| **NodeMCU V3** | ESP8266，**CH340** 串口芯片，**Type-C** 接口 | 2 块 | 十几元/块 | ① 认准 CH340 不是 CP2102（驱动好装）；② 认准 Type-C 不是 Micro-USB（和手机线通用）；③ 让卖家确认是 **V3**（LoLin 版型，引脚多、供电稳） |

**为什么 NTC 要 2 根**：一根贴在电池壳体上测电芯温度，另一根备用。探头线反复弯折容易在根部断，属于消耗品。

**为什么 NodeMCU 要 2 块**：一块装在板上跑，一块备用/对照。ESP8266 模块烧录时接错线烧掉的情况很常见，而且这东西从下单到到货要三四天，卡住就麻烦。

---

## 三、第 3 单：嘉立创 PCB 打样

**Gerber 已就绪，可以直接下单了。**

上传文件：`05_交付产物/Gerber/Gerber_下单版_100x80_2L.zip`（81 KB，11 个文件）

| 项 | 选定值 | 备注 |
|---|---|---|
| 板框 | **100 × 80 mm** | 与 100×100 同价，直接用大的；Gerber 实测 100.000 × 80.001 mm |
| 层数 | 2 层 | 顶层 + 底层走线，双面 GND 铺铜 |
| 板厚 | 1.6 mm | 唯一不加价档（常规板 0.8~1.6 mm）。2.0 mm 属非标，要换压合模具 |
| 铜厚 | **1 oz** | 标准档。2 oz 蚀刻时间延长、产能下降，基础费加价约 30% |
| 阻焊 / 丝印 | 绿油 / 白字 | 蓝/红/白阻焊每款加 50 元，绿油不加 |
| 表面处理 | **喷锡** | 沉金加 100 元，无铅喷锡加 30 元。手工焊接喷锡最好用 |
| 数量 | 5 片 | 打样起订量 |
| 拼板 | 不拼 | |
| SMT | **不要** | 全部元件自己焊 |
| 加急 | **不要** | 加急一天 200 元、两天 100 元 |

**下单包里有什么**：顶层铜 GTL、底层铜 GBL、顶/底丝印 GTO/GBO、顶/底阻焊 GTS/GBS、板框 GKO、金属化钻孔 DRL、非金属化钻孔 DRL（4 个 3.2 mm 安装孔）、过孔钻孔 DRL。
**已剔除 7 个非制造文件**（TopPasteMask、Document、DrillDrawing，以及 4 个 `Fabrication_Colorful*` 彩色丝印层）——彩色丝印那几层留着会被嘉立创系统当成「彩色丝印订单」而触发人工核对。原始完整包另存为 `Gerber_完整导出_备份.zip`。

**安装孔**：四角 M3，孔心距板边 5 mm → (5,5) / (95,5) / (5,75) / (95,75)，**非金属化**（NPTH），孔径 3.19989 mm。这 4 个孔是 PCB 钻孔，不是元件，不用买。

**装配五金（另买，淘宝）**：M3×8~10 mm 尼龙柱 4 根 + M3×6 mm 螺丝 4 颗（1.6 mm 板厚配 M3×6）。裸板使用，不装盒。

---

## 四、手上已有，不用买

| 物品 | 状态 |
|---|---|
| 野火小智核心板（STM32F103C8T6） | 有 |
| 江科大 30 项套件 | 有（含面包板、130 电机 + 风扇叶、0.96" OLED、TB6612 模块、光敏/热敏/蜂鸣器/电位器/按键/LED、**母对母杜邦线 60 根**） |
| 野火小智简配套餐 | 有（含 DAP 调试器、Type-C 线 2 根、杜邦线） |
| TB6612 驱动模块 | 有（模块本体，座子 M1 要买） |
| 3S 电池 / 电源 | 有，**目前借给同学**，用前要取回 |
| 面包板已验证电路 | 接线原样保留，一根没动 |

---

## 五、焊接耗材（如缺则一并买）

| 物品 | 用途 | 是否必备 |
|---|---|---|
| 焊锡丝 0.6–0.8 mm 含铅 | 手焊 0603/0805 用含铅的，熔点低好操作 | 必备 |
| 助焊剂（松香或免洗膏状） | 焊 0603 时靠它让锡自己爬到位 | 必备 |
| 吸锡带 | 焊连了补救 | 必备 |
| 尖头镊子 | 夹 0603 元件 | 必备 |
| 无水酒精 + 棉签 | 洗助焊剂残留 | 建议 |
| 放大镜 / 手机微距 | 检查虚焊 | 建议 |

---

## 六、下单检查单

- [ ] 立创购物车里逐个核对 22 个料号，特别是 **C14663 买 20 个**、**C111280 买 2 个**
- [ ] 确认购物车里 **没有** J4 的 C2905435 和 NTC 的 C9900004066
- [ ] 立创运费：不满 99 元要付运费（约 8 元）。如果只差一点，把 C14663、C17414 这类几分钱的料再加一点凑上去更划算
- [ ] 淘宝 NTC 下单前问清：**是裸 NTC 两线探头，不是 LM393 模块**
- [ ] 淘宝 NodeMCU 下单前问清：**CH340 + Type-C + V3**
- [ ] 收到货先点数，重点数 0603 的电容电阻有没有少
- [x] PCB 打样**可以下单了**，Gerber 见 `05_交付产物/Gerber/Gerber_下单版_100x80_2L.zip`
- [ ] 嘉立创上传 Gerber 后，确认系统识别出的层数 = 2、尺寸 = 100 × 80 mm、板厚 1.6 mm、铜厚 1 oz

---

**文档版本**：v1.1（2026-10-23 PCB 布线完成，Gerber 已导出，对应设计输入 v1.8 / 原理图规划 v1.6）

**v1.1 修订记录**

1. 第三节从「现在不能下」改为 **Gerber 已就绪可直接下单**，补上文件路径与下单包内容说明。
2. 补 **铜厚 1 oz** 一行（原表缺），并注明 2 oz 加价约 30%。
3. 补 **加急不要** 一行；表面处理明确选喷锡（沉金 +100 元、无铅喷锡 +30 元）。
4. 新增**装配五金**说明：M3×8~10 尼龙柱 4 根 + M3×6 螺丝 4 颗。
5. 下单检查单新增一条：上传后核对系统识别的层数/尺寸/板厚/铜厚。
