yunchuanli003/stm32-3s-battery-monitor/CHANGELOG.md

# 版本变更日志

## [2.1.0] - 2026-10-23

> PCB 版打样下单后，固件由面包板验证版的引脚配置迁移到 PCB 版，并升级温度换算方式。

### 🔄 适配与变更
- **引脚迁移**：ADC 由 IN0/IN1（PA0/PA1）改为 **IN4/IN5（PA4/PA5）**；TB6612 的 AIN1/AIN2/STBY 由 PA2/PA3/PA8 改为 **PB12/PB13/PB14**，端口由 GPIOA 改为 GPIOB
- **PWMA 不变**：仍在 PA6（TIM3_CH1）
- **NTC 换算升级**：由「25 ℃ 对应 1.65 V」的线性估算改为 **B 值法**，`R_ntc = R3 × V ÷ (3.3 − V)`，`1/T = 1/T0 + ln(R/R0) ÷ B`，其中 `R3 = 10 kΩ`、`R0 = 10 kΩ`、`B = 3950`、`T0 = 298.15 K`

### ✨ 新增功能
- **探头故障判定**：ADC > 4040 判开路、< 15 判短路，以 −99 / −98 表示；OLED 显示 `NTC--`，串口打印 `NTC-- (open|short)`
- **故障安全策略**：探头异常时温控逻辑直接停风扇，不基于不可信温度做判断

### 🔒 安全性
- **禁用电机反转**：`Motor_Backward()` 改为空实现（等同 `Motor_Stop()`）。设计文档对 D2 型号记载不一致（§2.2 记 SMBJ15CA 双向 TVS，§8.2 记 SS34 单向肖特基并称反转会短路），实物核对前按最坏情况处理

### 🔧 问题修复
- 修复 `fan_status == 99` 时 OLED 误显示为 `High 100%` 的问题，改为 ` -- ` 占位

### 🗂️ 工程维护
- `LYC1.ioc` 更名为 `LYC1.ioc.bak`：该文件早已与代码脱节（仅单通道 ADC，缺 I2C1 / TIM3 / DMA / 按键配置），在 CubeMX 中点「生成代码」会把现有驱动全部冲掉

### ✅ 验证
- Keil AC6 编译：**0 Error**，`Code = 16424`、`RO-data = 1208`、`RW-data = 48`、`ZI-data = 1368`
- Flash 占用约 27%（64 KB），RAM 约 7%（20 KB）

### ⚠️ 待实物验证
- `divider_k = 6.21` 为面包板实测值，新板电阻批次不同需复校
- NTC 探头必须为 B = 3950（非 3435），否则全量程偏移
- D2 实物丝印确认：SS34 还是 SMBJ15CA

---

## [2.0.0] - 2026-06-04

### ✨ 新增功能
- 实现电机PWM控制功能（TB6612驱动芯片）
- 实现按键控制系统（KEY2短按/长按状态机）
- 实现ADC电压采集功能（DMA双通道：电压 + 温度）
- 实现NTC温度采集与风扇三档迟滞调速（26/28/32℃）
- 实现OLED屏幕显示功能
- 实现DMA+USART串口通信功能（含发送完成确认）
- 实现电压越限声光报警与温度模拟测试模式

### 🔧 问题修复
- 修复按键无响应问题
- 修复串口打印延迟问题
- 修复按键逻辑错误问题
- 修复编译告警问题（未使用变量）

### 📝 项目文档
- 建立完整的项目文档体系
- 规范化目录结构
- 新增问题记录与解决方案文档
- 新增测试用例文档

### 🎯 硬件配置
- 主控芯片：STM32F103C8T6
- 电机驱动：TB6612
- 显示模块：0.96寸OLED（I2C）
- 供电：11.1V锂电池

---

## [1.0.0] - 2026-06-01

### ✨ 基础功能
- 项目初始化
- 基础GPIO配置
- 基础串口调试功能

---

## 版本说明

| 版本号 | 说明 |
|---|---|
| 主版本号 | 重大功能变更或架构调整 |
| 次版本号 | 新增功能或重要改进 |
| 修订号 | Bug修复或小优化 |
