yunchuanli003/stm32-3s-battery-monitor/01_文档资料/02_问题跟踪/20260603_电机风扇调试日志_v1.0.md

# 调试测试日志

## 项目信息
- **项目名称**: LYC1 STM32F103C8T6
- **记录日期**: 2026-06-03
- **硬件平台**: 江科大STM32F103C8T6开发板 + 面包板
- **涉及模块**: TB6612电机驱动

---

## 问题记录

### 问题1: 电机无法转动

#### 问题描述
- **现象**: 代码配置正确，GPIO和PWM输出正常，但电机始终无法转动
- **排查过程**:
  1. 检查代码中GPIO配置（PA2, PA3, PA6）- 正常
  2. 检查TIM3 PWM配置 - 正常
  3. 检查TB6612接线 - 接线正确
  4. 测量电机驱动引脚电压 - 发现异常

#### 根本原因
**江科大套件中的面包板电源轨是分段的，左右两侧不连通**，导致：
- STM32开发板的GND与电机驱动模块的GND不共地
- 电机驱动模块电源与STM32之间存在电位差
- 控制信号无法正确识别

#### 解决方案
**连接面包板的电源轨，让所有部件共地**：
1. 用杜邦线连接面包板左侧和右侧的GND轨
2. 用杜邦线连接面包板左侧和右侧的VCC轨
3. 确保STM32、TB6612、电机电源共地

#### 验证结果
- ✅ 共地后电机正常转动
- ✅ GPIO测试模式正常工作
- ✅ PWM调速功能正常

---

## 硬件连接说明

### 更正后的正确接线

| STM32引脚 | TB6612引脚 | 面包板 | 备注 |
|---|---|---|---|
| PA2 | BIN1 | - | 电机方向控制 |
| PA3 | BIN2 | - | 电机方向控制 |
| PA6 | PWMB | - | PWM调速 (TIM3_CH1) |
| GND | GND | GND 轨 | 共地！重要！ |
| 5V | VCC | VCC 轨 | 逻辑电源 |
| - | STBY | 3.3V | 使能芯片 |
| - | VM | 外部电源 | 电机电源(12V) |

> **重要提示**: 面包板两侧电源轨必须用杜邦线连通！

---

## 经验总结

1. **共地问题是嵌入式调试的首要检查点**
2. **面包板电源轨分段是常见陷阱**，务必用万用表确认
3. **多模块系统必须确保所有模块GND连接在一起**
4. **调试时先检查硬件连接，再检查软件配置**

---

---

## 问题记录（续）

### 问题2: 温度模拟模式下风扇/电机不工作

#### 问题描述
- **现象**: 温度模拟模式下风扇不转，正常温控逻辑也有问题

#### 根本原因（修正版）
**低级错误**: 误以为风扇和电机是两个独立设备，实际上：**
- **130直流电机转轴上插着风扇！
- **电机转 = 风扇转！
- **控制电机PWM = 控制风扇转速！

之前错误地把风扇和电机分成两个PWM通道，导致逻辑混乱。

#### 解决方案
**统一控制逻辑：电机即风扇：**
1. **删除独立风扇PWM控制（TIM3_CH2）
2. **所有风扇控制改用 `Motor_Forward(speed)` - 设置电机速度=风扇速度
3. **停止风扇 = `Motor_Stop()` - 停止电机=停止风扇
4. **初始化只需要 `Motor_Init()` 即可

---

### 问题3: 电机从未初始化导致不工作

#### 问题描述
- **现象**: 代码编译正常但电机/风扇不转
- **原因**: `Motor_Init()` 从未在 main.c 中被调用！
- **解决**: 在初始化阶段调用 `Motor_Init()` 和 `Motor_Enable()`

---

## 硬件接线（最终正确版）

| STM32引脚 | 功能 | 连接到 | 说明 |
|---|---|---|---|
| PA2 | GPIO输出 | TB6612 BIN1 | 电机方向 |
| PA3 | GPIO输出 | TB6612 BIN2 | 电机方向 |
| PA6 | TIM3_CH1 PWM | TB6612 PWMB | 电机PWM=风扇PWM |
| PA8 | GPIO输出 | TB6612 STBY | 拉高使能电机 |
| PC13 | GPIO输入 | KEY2按键 | 短按模拟模式 |
| PB0 | GPIO输出 | 蜂鸣器 | 报警 |
| PB1 | GPIO输出 | LED | 报警指示灯 |
| GND | 共地 | 所有模块GND连在一起！ |

> **🔴 **关键：风扇直接插在130电机转轴上，电机转=风扇转！

---

## 系统功能总结

| 功能 | 说明 |
|---|---|
| 电池电压监测 | 9.0V-12.6V，异常时LED+蜂鸣器报警 |
| 温度监测 | NTC热敏电阻 |
| OLED显示 | 实时显示电压、温度、风扇状态 |
| 温控风扇 | 迟滞控制：26°C停/28°C低速/32°C高速 |
| K2短按 | 温度模拟模式（模拟35°C） |
| K2长按3秒 | 暂停系统 |
| RESET按钮 | 硬件复位重启 |

---

## 代码修改记录

| 日期 | 修改内容 | 文件 |
|---|---|---|
| 2026-06-03 | 删除GPIO电机测试代码 | main.c |
| 2026-06-03 | 添加电机初始化Motor_Init/Motor_Enable | main.c |
| 2026-06-03 | 修正：电机转=风扇转，统一用Motor_Forward/Stop控制风扇 | main.c |
| 2026-06-03 | 温度模拟模式启动电机=启动风扇 | main.c |
| 2026-06-03 | 系统停止时停止电机=停止风扇 | main.c |
