yunchuanli003/stm32-3s-battery-monitor/02_固件代码/STM32F103C8T6/LYC1/Core/Inc/main.h

#define BEEP_Pin GPIO_PIN_0
#define BEEP_GPIO_Port GPIOB
#define LED_Pin GPIO_PIN_1
#define LED_GPIO_Port GPIOB
#define KEY2_Pin GPIO_PIN_13
#define KEY2_GPIO_Port GPIOC
