yunchuanli003/stm32-3s-battery-monitor/(commit log)

2026-10-21 feat: 初始化 3S 锂电池电压监测与智能散热系统
    - 固件工程：STM32F103C8T6 + HAL，Core/Drivers/MDK-ARM/CubeMX 配置
    - 采集：ADC1 双通道扫描 + DMA 循环搬运（电压 PA0 / 温度 PA1）
    - 控制：TB6612 PWM 三档迟滞温控（26/28/32℃），电压越限声光报警
    - 交互：OLED I2C 状态显示、USART1 日志输出、KEY2 短按/长按状态机
    - 文档：开发计划、问题记录与解决方案、代码风格规范
    - 验证：测试用例、测试脚本、BOM 物料、实物图与演示素材
2026-10-21 docs: 优化 README 展示效果
    - 新增压缩版实物图 assets/board-preview.jpg（11MB → 620KB），提升页面加载速度
    - 补充串口输出截图与演示视频链接
    - 修正版本记录与 CHANGELOG 一致性
2026-10-21 chore: 忽略 .workbuddy 工作目录
    - 该目录存放本地对话记忆，属于个人内容，不应进入公开仓库
    - 之前误提交的 2026-10-21.md 已从历史中移除（该提交未推送）
2026-10-21 chore: 忽略 .trae 与其他临时产出目录
2026-10-21 docs: 归并问题修复计划并规范文档命名
2026-10-21 chore: 清理无关文件并压缩演示素材
    - 移除 BOM 购物网站截图 3 张（电商页面截图，非技术资料）
    - 移除 Keil 编译产物 LYC1.l 与 RTE_Components.h（自动生成）
    - 移除 3 份文件夹整理过程记录（与本项目技术内容无关）
    - 演示视频 19 MB -> 5.9 MB（CRF 31，1280x720 保持）
    - 实物图 10.9 MB -> 356 KB（长边 1920，质量 82）
    - 参考资料与个人材料统一移入杂项目录并整体忽略
    - 修复 .gitignore 两处失效：CRLF 换行导致规则不匹配、
    含斜杠的 MDK-ARM 规则只匹配仓库根目录
    [mock_esp_server.py, web_preview_server.py]
2026-10-21 chore: 移除重复的 assets/board-preview.jpg
    该图与 05_交付产物/演示素材/项目2.0实物图.jpg 为同一张照片的两个压缩版本
    （1400x2489/618KB vs 1080x1920/356KB），保留后者，删除前者。
    同步更新引用：
    - README.md 首页图片地址
    - README.md 目录结构树
    - 03_硬件设计/PCB设计/20261021_引脚冲突核查_v1.0.md 证据 3
    仓库减少 618.5 KB。
2026-10-23 feat(hw): PCB 设计与打样文件定稿（Gerber / 3D 效果图 / 原理图 PDF）
    PCB：100 × 80 mm 双层板，39 元件、200 段走线、52 个过孔、2 块 GND 铺铜，
    DRC 0 违规；四角 M3 非金属化安装孔；1.6 mm / 1 oz / 绿油 / 喷锡。
    新增交付产物：
    - 05_交付产物/Gerber/ 下单版（11 文件，81 KB）+ 完整导出备份（18 文件）
    - 05_交付产物/PCB效果图/ 3D 渲染三视角（等轴测 / 正俯视 / 低角度透视）
    - 05_交付产物/原理图/ 四页 PDF（858 × 609 pt）
    文档：
    - README 硬件章节重写为 PCB 版：4.1 规格 / 4.2 3D 渲染 / 4.3 PCB 版引脚
    （含板载 KEY1 与 RGB LED 冲突说明）/ 4.4 元件 / 7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
2026-10-23 docs: 实物图换白底版，移除技术文档中的求职提法
    - 05_交付产物/演示素材/项目2.0实物图.jpg: 1920x1440 白底重拍版，替换原 1080x1920 竖图
    - README 4.5: 图片宽度 420 -> 760 适配横构图，图注去掉未入镜的电池组
    - PCB打样设计输入 v1.0: 18 行「面试时」->「工程上」，457 行「对秋招推荐」->「工程上推荐」
2026-10-23 fix(docs): 修复原理图 PDF 第 3 页备注文字重影
    EDA 源文件 P3 图页在历次脚本重建中累积了 10 组重叠文本框（60 个对象），
    导出 PDF 后形成上下错位的双层文字，几乎无法阅读。
    EDA 侧：删除其中 54 个对象，只保留最后创建的完整 6 行（P3 文本 60 -> 6，
    元件 41、导线 31 均未变动），已保存。
    PDF 侧：重写第 3 页备注区（89,376)-(402,456)，按原基线逐 span 还原中英文
    与全角标点，宋体子集嵌入；第 1/2/4 页像素零差异。
    体积 731,568 -> 516,283 字节。文本层可正常提取，中文 178 字完整。
2026-10-23 feat(fw): 固件适配新 PCB 引脚，NTC 改用 B 值法换算
    原理图与 PCB 定稿后引脚有变动，固件同步适配，使烧录后即可在新板运行。
    引脚变更（对应 PCB 设计输入 v1.8 网表）：
    - ADC：IN0/IN1 (PA0/PA1) → IN4/IN5 (PA4/PA5)
    电池电压分压 → PA4，NTC 探头 → PA5
    - 电机：PA2/PA3/PA8 → PB12/PB13/PB14（AIN1/AIN2/STBY）
    端口 GPIOA → GPIOB，时钟使能与 HAL_GPIO_Init 同步
    - PWMA 仍在 PA6 (TIM3_CH1)，未变动
    温度换算：
    - 原「25℃ 对应 1.65V」的线性估算误差可达十几度，改按 NTC B 值法：
    R_ntc = R3 × V / (3.3 − V)，1/T = 1/T0 + ln(R/R0)/B
    R3 = 10 kΩ 上拉，R0 = 10 kΩ，B = 395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
2026-10-23 docs: README 与 CHANGELOG 同步到 v2.1.0
    固件已在 0f76d46 完成 PCB 版引脚适配，但 README 仍写着「此项尚未完成」，
    引脚描述也停留在面包板版的 PA0/PA1/PA2/PA3/PA8，会误导阅读者。
    README.md
    - 2.1 核心功能：ADC1_CH0(PA0)/CH1(PA1) → CH4(PA4)/CH5(PA5)
    - 三、系统架构图：同上两处节点
    - 4.3 节：「此项尚未完成」→「已于 2026-10-23 完成（v2.1.0，提交
    0f76d46）」，明确当前固件可直接烧录 PCB 版
    - 4.5 节面包板引脚表后加注：该表为历史记录，PCB 版见 4.3，两者不可混用
    - 5.1 模块表：「CubeMX 生成的外设初始化」→ 注明现为手工维护，
    .ioc 已更名为 L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
2026-10-23 docs: 项目简介补充车载电子设备场景
    将应用场景从「无人机 / 机器人锂电池组」扩展为「车载电子设备、无人机与机器人锂电池组」，明确 12 V 锂电供电的车载电子设备这一适用面。
    措辞限定在「车载电子设备」而非「汽车电气系统」：本板为 3S（9.0~12.6 V），与车载电子设备的 12 V 锂电输入端电压区间重合；而汽车电气系统在发电机工作时为 13.8~14.4 V，会触发本系统 12.6 V 过压阈值。
2026-10-23 docs: 新增 20261024 采购记录，含 LED1 封装兼容性结论
    新增 03_硬件设计/采购记录_20261024.md（186 行）：
    - 21 项立创元件 + 3 项淘宝物料的位号对照表（板用/买入/余量/料号/单价）
    - 8 个失效料号的替换对照（按型号重查，C 编号随品牌批次下架）
    - 装配尺寸验算：尼龙柱超出板边、螺杆咬合长度、螺丝头位置
    - 到货验收四步与焊接前分装清单
    LED1 结论按实际封装参数写入：板上 LED-3MM 孔径 0.9 mm、焊盘间距 2.54 mm，Φ5 LED（引脚 0.6 mm、脚距同为 2.54 mm）完全可焊，只需留 2 mm 悬空焊接避免本体凸缘压住焊盘。
2026-10-25 docs: 技术文档改为客观陈述，补充有铅工艺的环保说明
    - 问题跟踪与设计输入：将主语改为现象/电路/本设计，去掉对话式措辞
    - 设计输入 0 节：标题简化为「三个设计前提」
    - 采购清单：库存核对改为客观记录
    - 设计输入 7 节、采购记录：说明有铅喷锡仅为样机手焊便利，商品化须改无铅
    并按 RoHS 2011/65/EU 与 GB/T 26572 核查 22 个料号有害物质
2026-10-25 docs: 补充安全须知，明确分层许可证与第三方组件声明
    - README 顶部增加锂电池警示条，文末新增「十三、安全须知」7 条
    - 许可章节拆分为三层：自写代码 MIT / 硬件设计 CC BY-SA 4.0 / 第三方组件各自许可
    - 修正 CMSIS 许可：实为 Apache-2.0，原文误标为 BSD-3-Clause
    - 新增 THIRD-PARTY-NOTICES.md，逐项列明 ST HAL、CMSIS、启动文件的许可与版权
    - 新增 7.6 无硬件预览说明，标注两个预览脚本监听 0.0.0.0 且无鉴权
2026-10-25 test: 补录按键控制 8 条用例的实际结果与判定
    - TC-001 ~ TC-008 补全「实际结果」与「是否通过」
    - 补齐结果汇总表与总体测试结论：通过 8 / 失败 0
    - 测试环境补测试日期 2026-06-04 与被测固件 v2.0.0
    - 备注说明 TC-001~TC-005 为状态机修复后复测，TC-002/TC-004 修复前实测不通过
2026-10-25 chore: 中性化 .gitignore 注释，为 ioc 归档增加例外
    注释改为描述用途本身，不再记录本地目录的整理动机；
    LYC1.ioc.bak 虽被 *.bak 排除，但已入库且需长期追溯，增加取反规则避免后续改动不被追踪
2026-10-25 docs: 修正 7.1 的 CubeMX 重生成建议与 7.2 的 hex 适用范围
    - 7.1 原句指导读者用 CubeMX 重新生成代码，会覆盖现有手工维护的驱动，
    且与 5.1「已更名 LYC1.ioc.bak、不再回写」自相矛盾；改为明确警示
    - 7.2 标注 LYC1_v2.0.hex 为面包板引脚映射（PA0-PA3/PA8），不可直接烧 PCB 版
    - 目录树同步 LYC1.ioc.bak 与 THIRD-PARTY-NOTICES.md
2026-10-25 docs: 区分测试用例（手工执行）与测试脚本（软件仿真）
    原句「测试用例与自动化脚本」会被读成仓库含自动化测试套件，
    实际 4 个 Python 脚本均为纯软件仿真/mock（test_voltage 复现电压换算公式、
    uart_send_verify 用 MockUART 复现 TC 标志时序、另两个为网页预览与接口 mock），
    无一连接硬件。改为按子目录逐项标注性质，并注明仿真不能替代硬件实测。
2026-10-25 docs: 补充测试条件与测试范围局限说明
    第八节原 6 项结论只有「方法 + 结果」，缺复现条件与测试层级，
    检测岗会追问仪器型号、测试轮次与判定依据。
    新增 8.1 测试条件：ADC 分辨率/参考电压、1 Hz 采样周期、分压系数 6.21、
    NTC 参数、风扇阈值与回差、长按判定与消抖时间，全部标注 main.c 中的代码依据。
    新增 8.2 测试范围与局限：明确为个人样机功能验证而非型式试验，
    未做 GB/T 2423 环境试验与 EMC 预测试，仪器型号未逐项归档，
    72 h 判定依据为串口日志而非协议层计数器。
2026-10-25 fix: 删除未实际执行的「72 h 无丢帧」测试声明
    该项目实际通电运行时长仅约 15 min，用于功能确认，从未做过 72 小时连续
    运行与丢帧统计。原表述属未经验证的量化声明，已删除表格行。
    8.2 改为如实说明：未做长时间稳定性验证，串口仅验证 1 Hz 数据输出的
    解析正确性，无协议层计数器。
2026-10-25 fix: 温度与风扇测试结论改为逻辑验证口径
    经确认：所谓「加热/降温全程观测 0~60 ℃」并未发生，风扇与 OLED 联动只在
    固件写死 35 ℃ 的温度模拟模式下确认过；风扇切换时间与 26/28 ℃ 迟滞均未做
    实物复核，作者本人亦无法确认。
    - 测试表删除「温度采集范围」「风扇调速响应」「迟滞逻辑」三行
    - 新增说明：该项为逻辑验证而非实测，不声明测温范围与精度
    - 8.2 补充两条局限：未验证 NTC 实际测温链路、未做迟滞阈值实测复核
2026-10-25 docs: 标注分压系数 6.21 属旧配置校准结果
    6.21 是在 ADC 仍在 PA0、且 PA0 被板载 KEY1 并联的状态下标定的。
    ADC 迁至 PA4 后分压网络变干净，PCB 版又换用 1% 电阻（理论 6.10），
    两处文档均要求重新标定，但代码未复校。
    - 8.1 分压系数行加「待新板复校」
    - 8.2 说明「误差 ≤ 0.02 V」为旧配置结果，不代表当前代码在新板上的精度
    - 8.2 NTC 条目按实情改写：探头实装前已校准，但未留存比对记录，故不声明测温精度
2026-10-29 docs(hw): 采购清单定版 v2.0，标注 v1.0 作废
    - 20261023_采购清单 更名为 v2.0：范围由「WiFi 验证阶段」扩展为全量三单，
    与原 v1.0 属重写关系，非小修，故升主版本号
    - 20261022_采购清单 v1.0 状态改为「已作废」，保留作决策留档
    - 同步更新 README 的 BOM 链接与采购记录的依据行
