yunchuanli003/stm32-3s-battery-monitor/(notices)

Notices in the files:
02_固件代码/STM32F103C8T6/LYC1/Core/Src/main.c:
Copyright (c) 2026 STMicroelectronics.
All rights reserved.
This software is licensed under terms that can be found in the LICENSE file
README.md:
License: MIT
